stanley-fork/Blackpants/ee/integrated/out/R1.0/fab/asm/2_IMG_20260211_160602.jpg

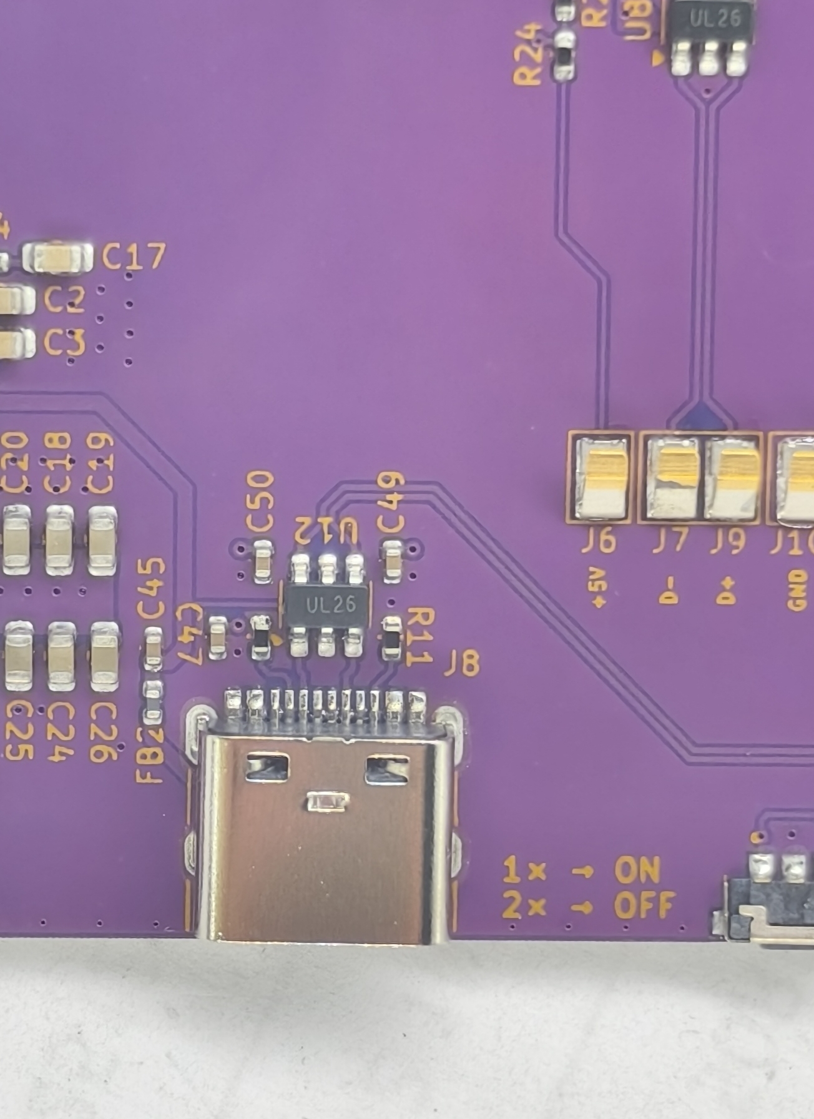
ee/integrated/out/R1.0/fab/asm/2_IMG_20260211_160602.jpg
