stanley-fork/Blackpants/ee/integrated/out/R1.0/fab/asm/3_IMG_20260211_160544.jpg

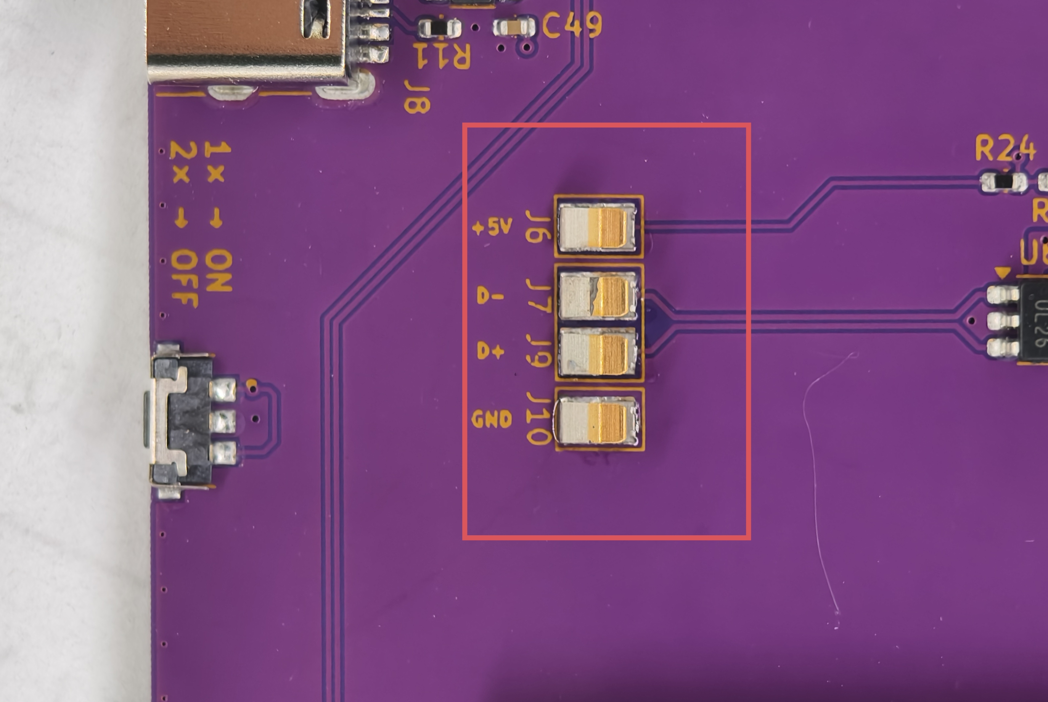
ee/integrated/out/R1.0/fab/asm/3_IMG_20260211_160544.jpg
