stanley-fork/Blackpants/ee/integrated/out/R1.0/readme.txt

Size :	90 x 153 mm
Layer : 4 Layers
Material : FR-4 : S1000H TG150
Thickness : 1.6 mm
Min track/spacing :	4/4mil
Min hole size : 0.2mm
Solder mask : Purple
Silkscreen : Yellow
Edge connector : No
Surface finish : Immersion gold(ENIG) (1U")
Via process : Tenting vias
Finished copper : 1 oz Cu (Inner Copper:1 oz)
Remove product No. : Yes
