stanley-fork/Blackpants/ee/integrated/out/R1.0/fab/asm/1_IMG_20260211_160616.jpg

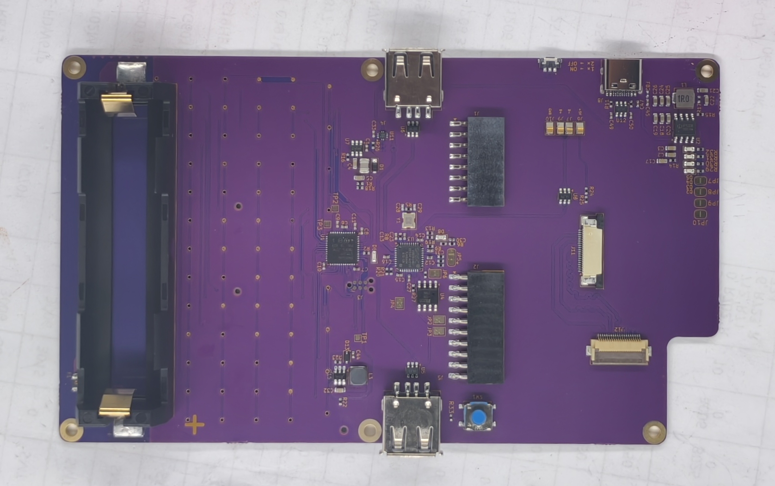
ee/integrated/out/R1.0/fab/asm/1_IMG_20260211_160616.jpg
