stanley-fork/Blackpants/ee/integrated/out/R1.0/fab/asm/4_IMG_20260211_160531.jpg

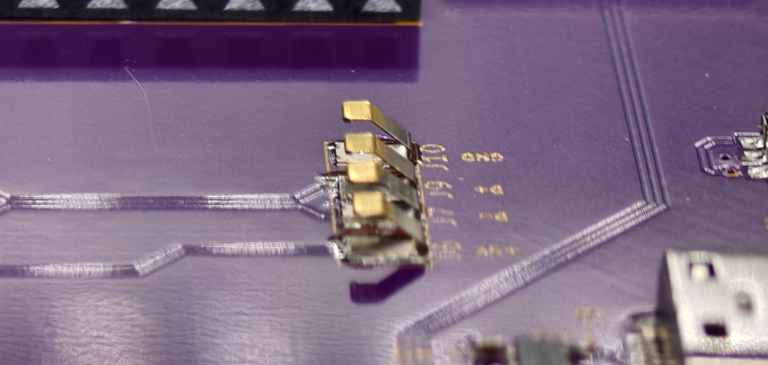
ee/integrated/out/R1.0/fab/asm/4_IMG_20260211_160531.jpg
