stanley-fork/Blackpants/ee/blackpants/step/f32q_20pin_asm.stp

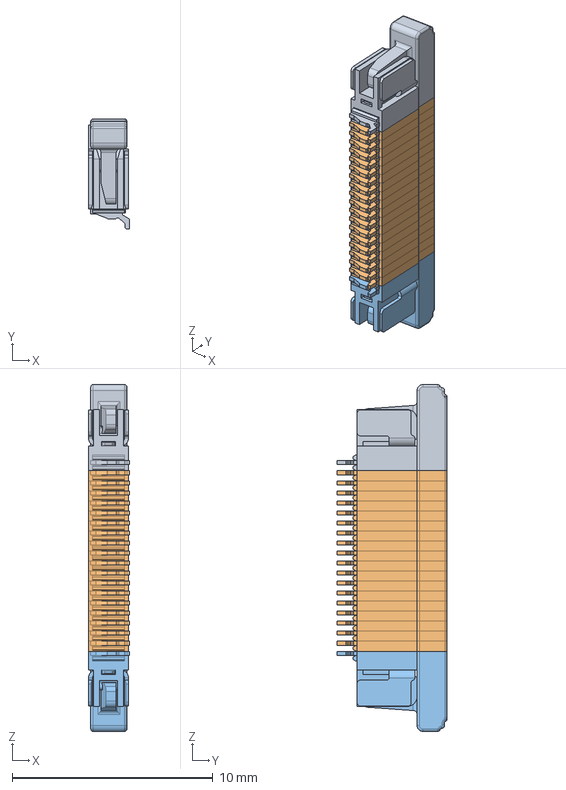
[picture p5: CAD file, 2026-06-06]
ee/blackpants/step/f32q_20pin_asm.stp
2.05 x 5.50 x 17.3 mm
F32Q_L
F32Q_M x 18
F32Q_R
