stanley-fork/Blackpants/ee/blackpants/step/usb1046-xx-0190-l-b-x_revb1.step

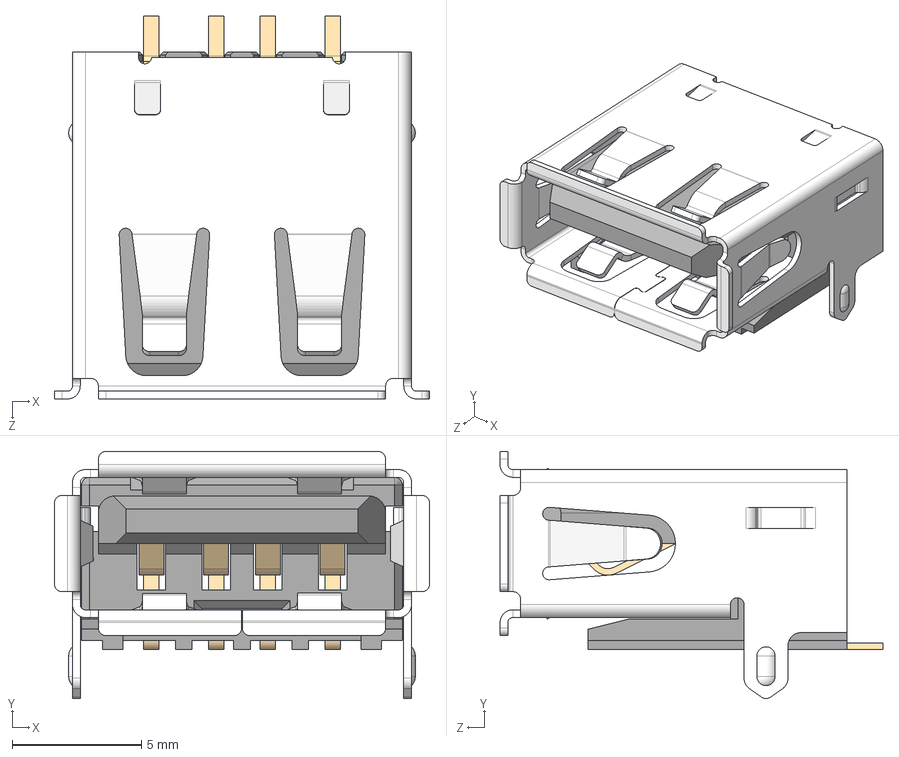
[picture p6: CAD file, 2026-06-06]
ee/blackpants/step/usb1046-xx-0190-l-b-x_revb1.step
14.5 x 9.55 x 14.8 mm
INS
USB1046 shell
USB1046 Contact x 4
