stanley-fork/Blackpants/ee/integrated/Abracon/eec.models/Abracon_-_ABS05-32.768KHZ-9-T.step

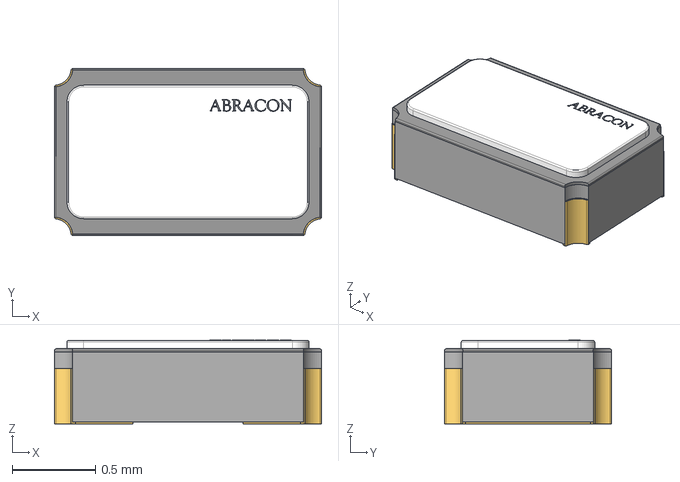
[picture p7: CAD file, 2026-06-06]
ee/integrated/Abracon/eec.models/Abracon_-_ABS05-32.768KHZ-9-T.step
1.60 x 1.00 x 0.501 mm
