stanley-fork/Blackpants/ee/integrated/AS4C512M16D3L/eec.models/Alliance_Memory_-_AS4C512M16D3L-12BIN.step

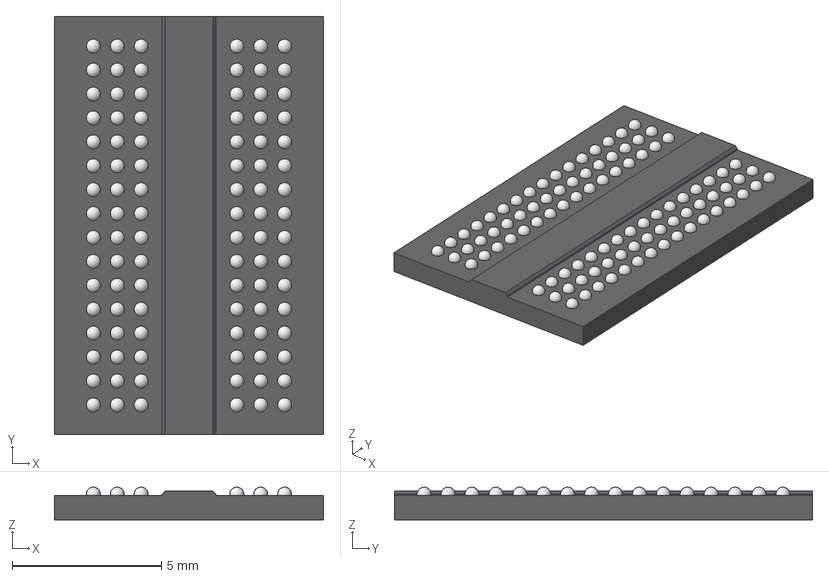
[picture p8: CAD file, 2026-06-06]
ee/integrated/AS4C512M16D3L/eec.models/Alliance_Memory_-_AS4C512M16D3L-12BIN.step
9.00 x 14.0 x 1.09 mm
Part1cvcvcv
Part2sdsdsdsd x 48
Part2sdsdsdsd_MIR x 48
