stanley-fork/Blackpants/ee/integrated/MPM-15-5/eec.models/MEAN_WELL_-_MPM-15-5.step

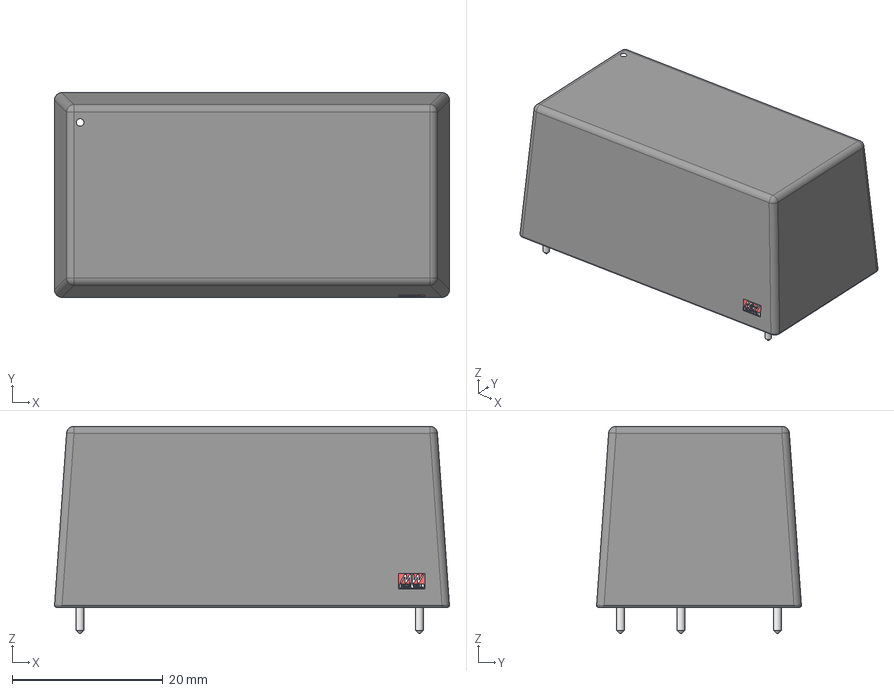
[picture p9: CAD file, 2026-06-06]
ee/integrated/MPM-15-5/eec.models/MEAN_WELL_-_MPM-15-5.step
52.4 x 27.2 x 27.5 mm
Leads
Mean Well logo
Mean Well txt
Frame
Sillkscreen dot
