stanley-fork/Blackpants/ee/integrated/step/Coilcraft-XAL4020.step

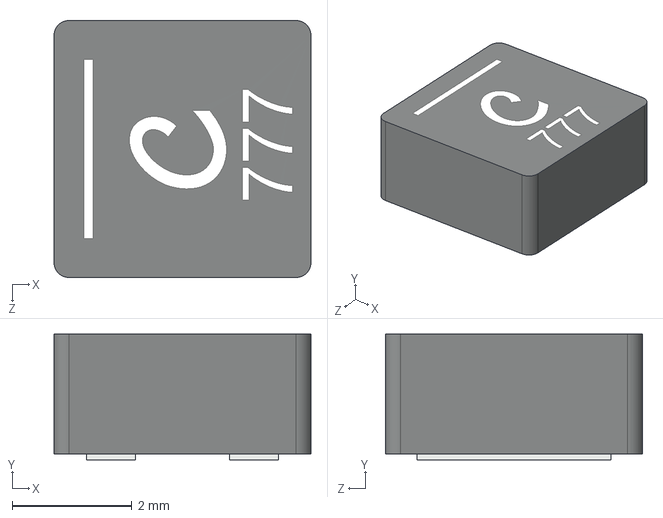
[picture p11: CAD file, 2026-06-06]
ee/integrated/step/Coilcraft-XAL4020.step
4.30 x 2.10 x 4.30 mm
