stanley-fork/Blackpants/ee/integrated/step/CONREVSMA002-G.step

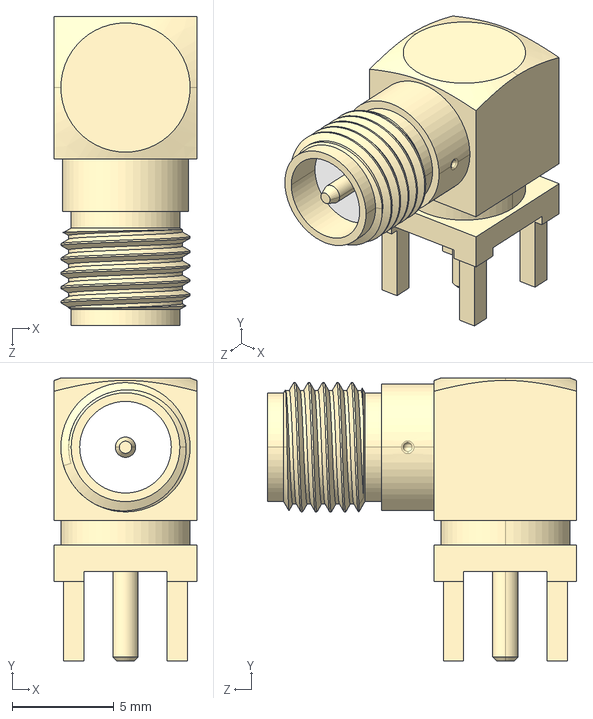
[picture p12: CAD file, 2026-06-06]
ee/integrated/step/CONREVSMA002-G.step
7.00 x 13.9 x 15.2 mm
