stanley-fork/Blackpants/ee/integrated/step/DM3AT-SF-PEJM5.stp

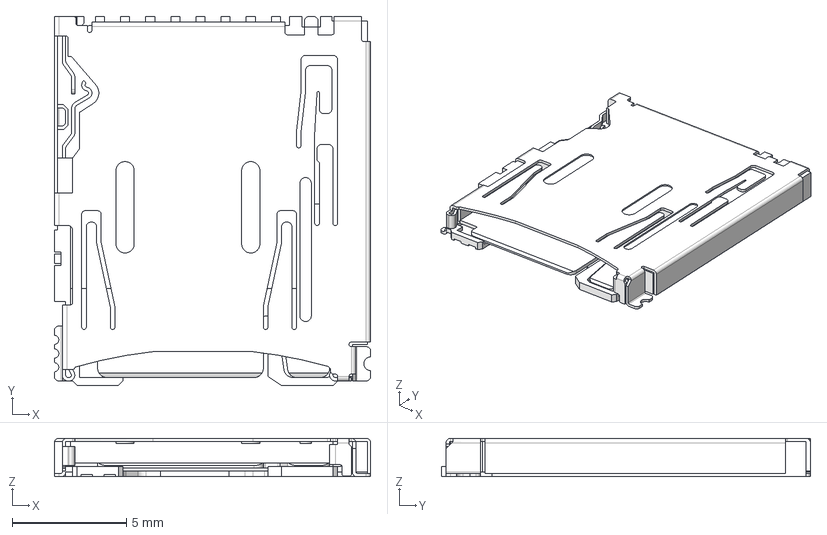
[picture p13: CAD file, 2026-06-06]
ee/integrated/step/DM3AT-SF-PEJM5.stp
13.8 x 16.2 x 1.68 mm
