stanley-fork/Blackpants/ee/integrated/1050570001/1050570001.stp

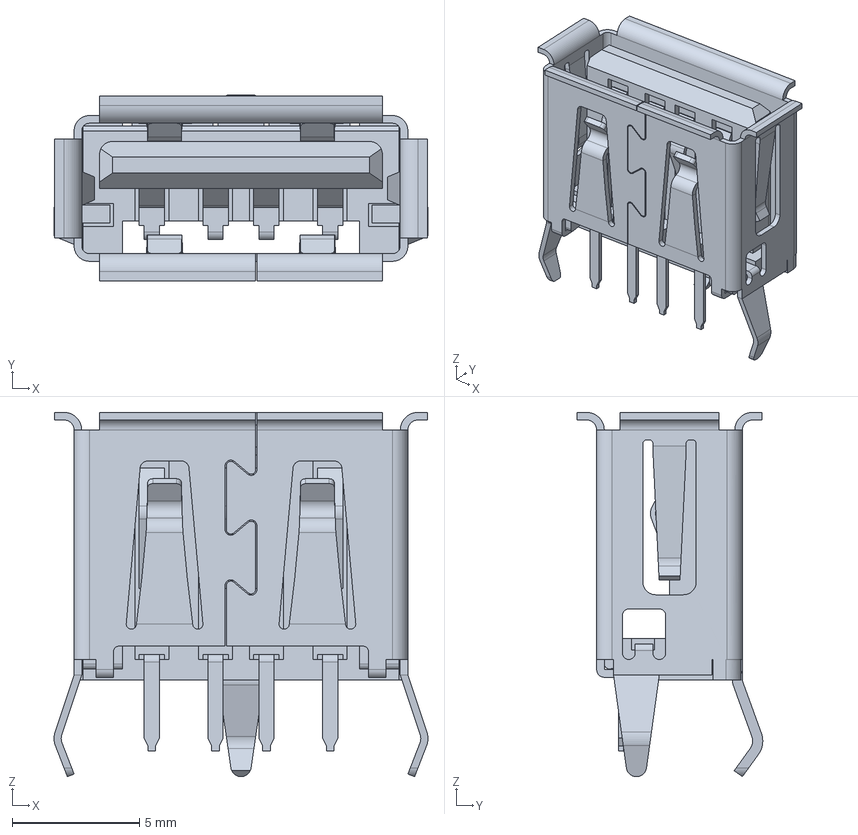
[picture p14: CAD file, 2026-06-06]
ee/integrated/1050570001/1050570001.stp
14.7 x 7.28 x 14.3 mm
