stanley-fork/Blackpants/ee/blackpants/step/M20-7910842R.STEP

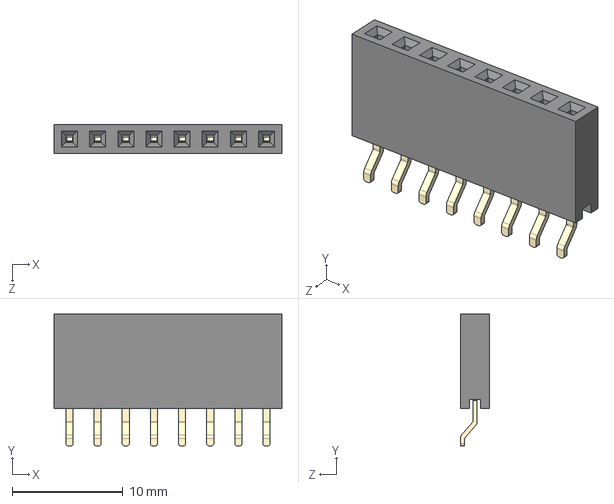
[picture p15: CAD file, 2026-06-06]
ee/blackpants/step/M20-7910842R.STEP
20.6 x 11.9 x 2.65 mm
