stanley-fork/Blackpants/ee/blackpants/step/M20-7911042R.STEP

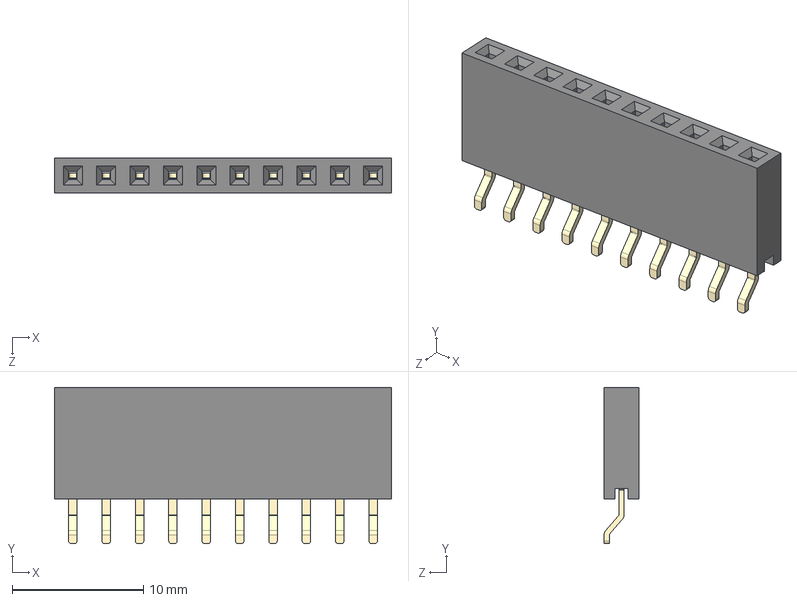
[picture p16: CAD file, 2026-06-06]
ee/blackpants/step/M20-7911042R.STEP
25.6 x 11.9 x 2.65 mm
