stanley-fork/Blackpants/ee/integrated/out/R1.0/blackpants.pdf

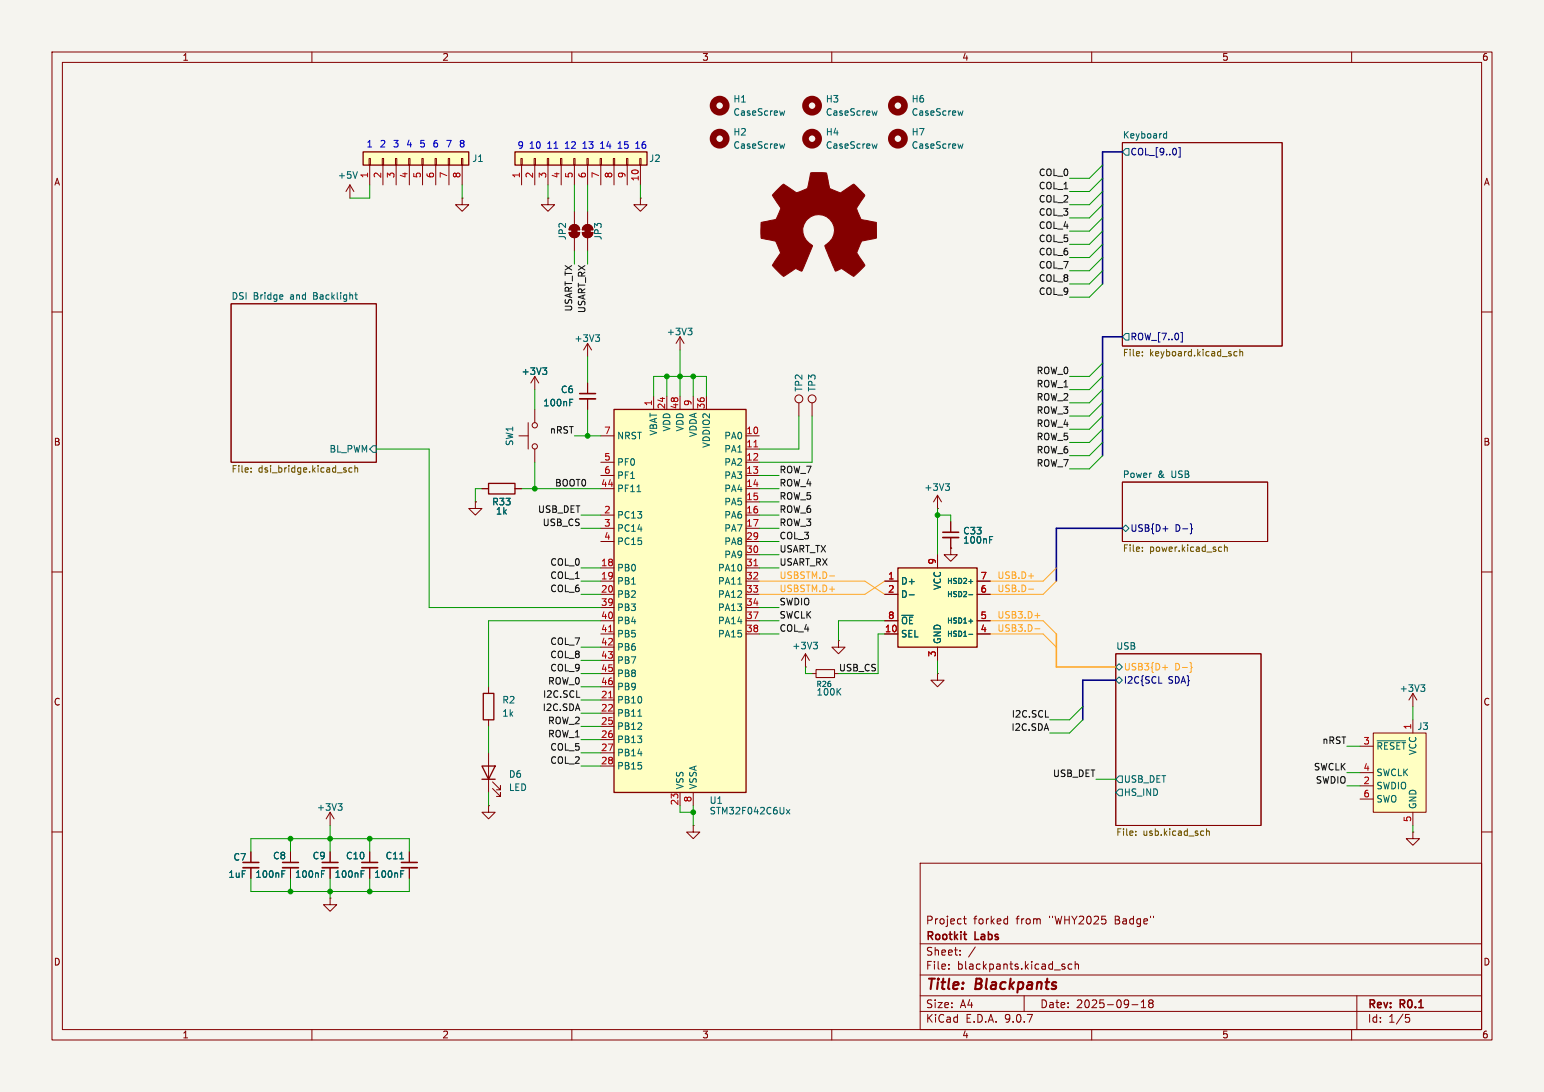
[picture p17: page 1]

DSI Bridge and Backlight File: dsi_bridge.kicad_sch

ROW_[7..0]
File: usb.kicad_sch USB{D+ D-} Power & USB

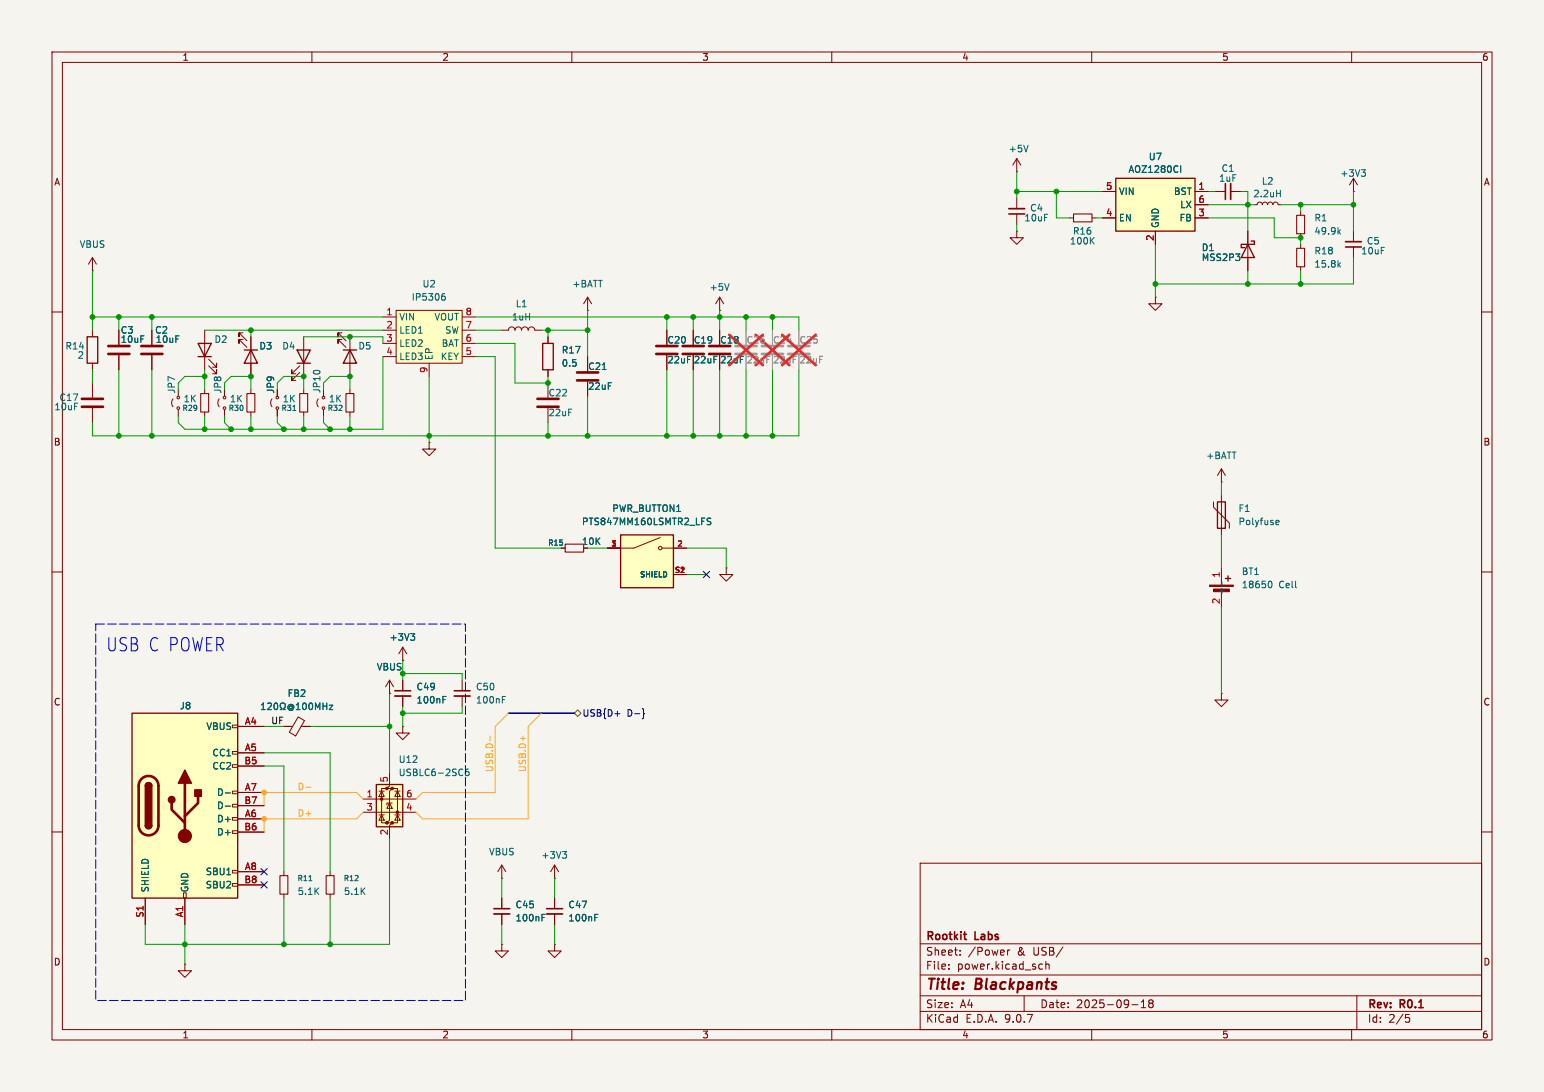
[picture p18: page 2]

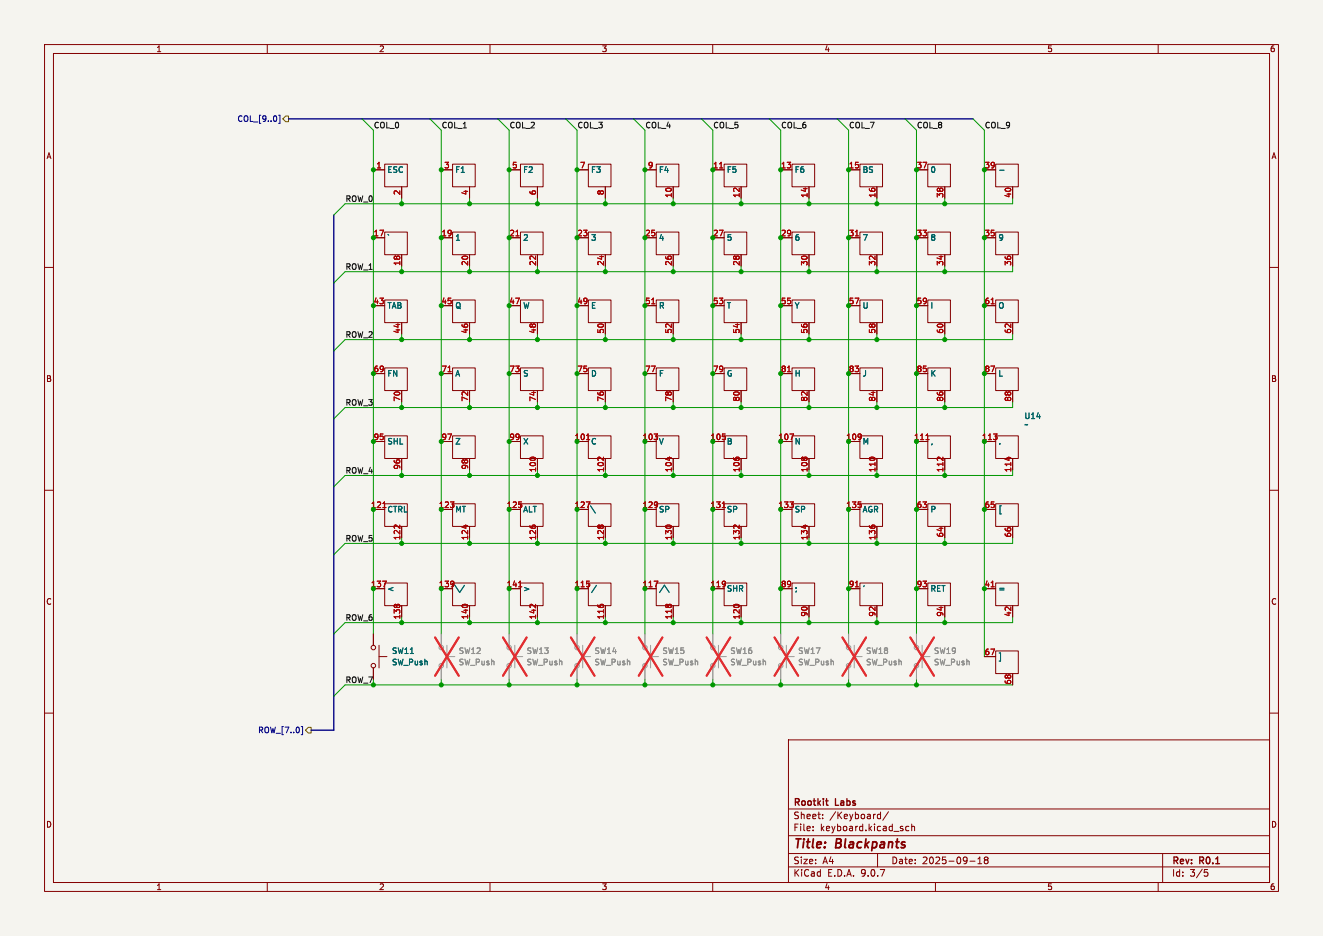
[picture p19: page 3]

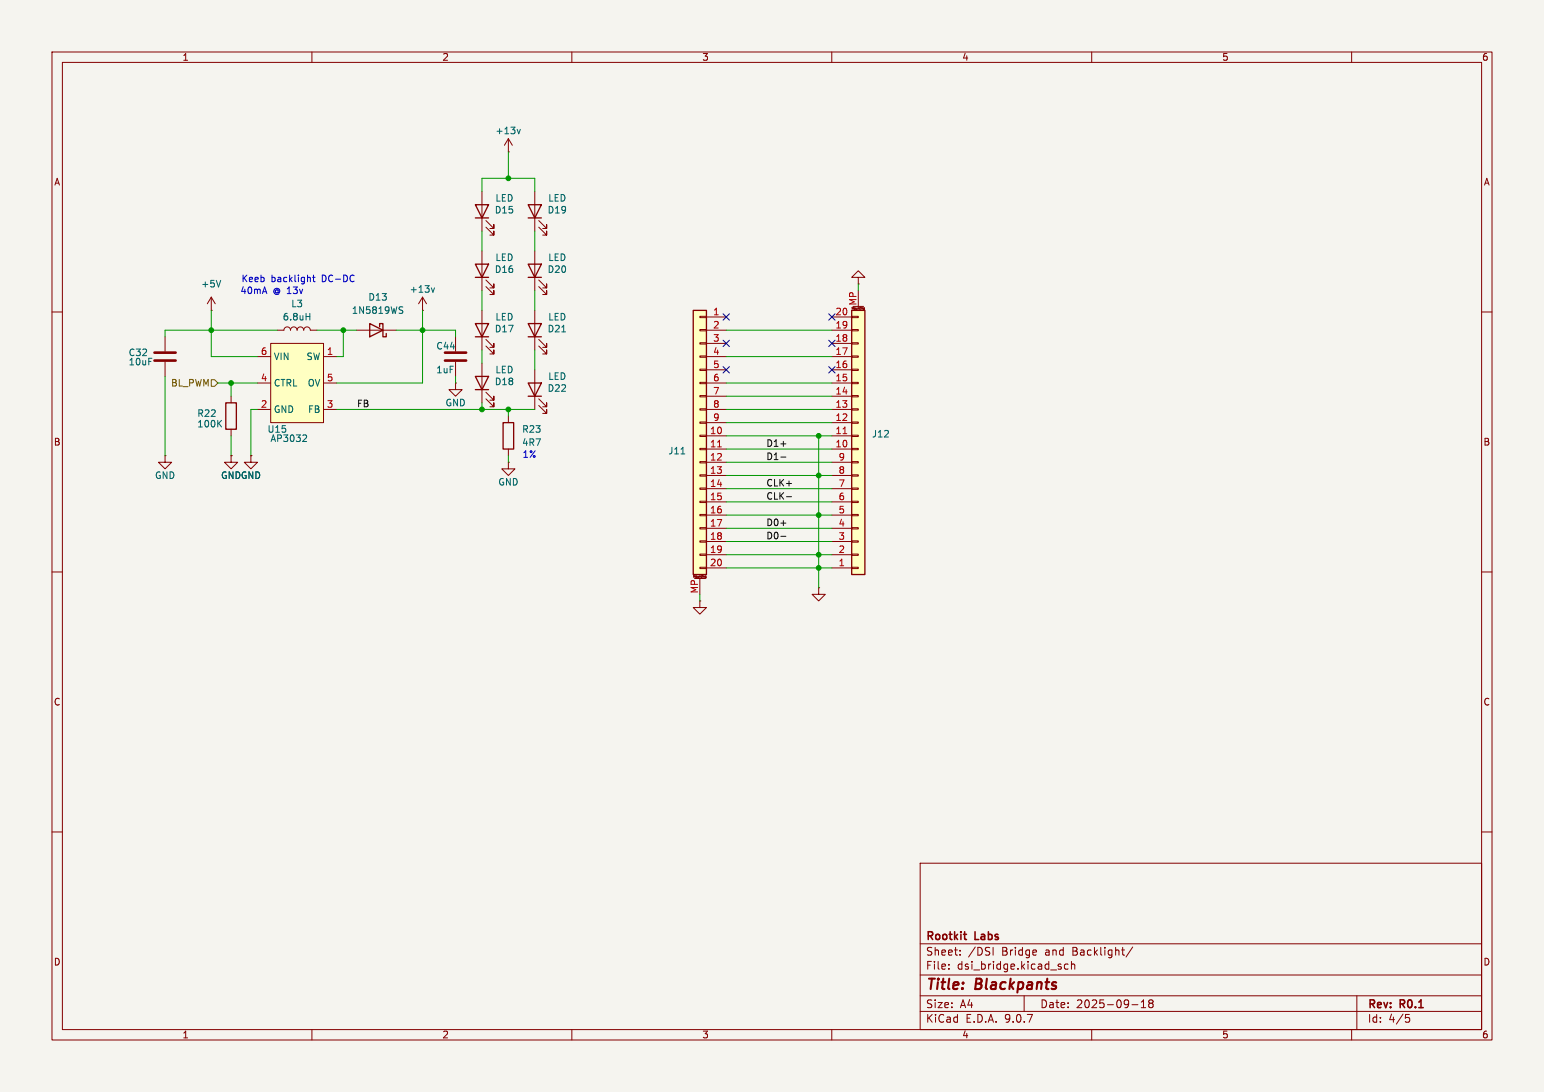
[picture p20: page 4]

11 | 10
12 | 9
13 | 8
14 | 7
15 | 6
16 | 5
17 | 4
18 | 3
19 | 2

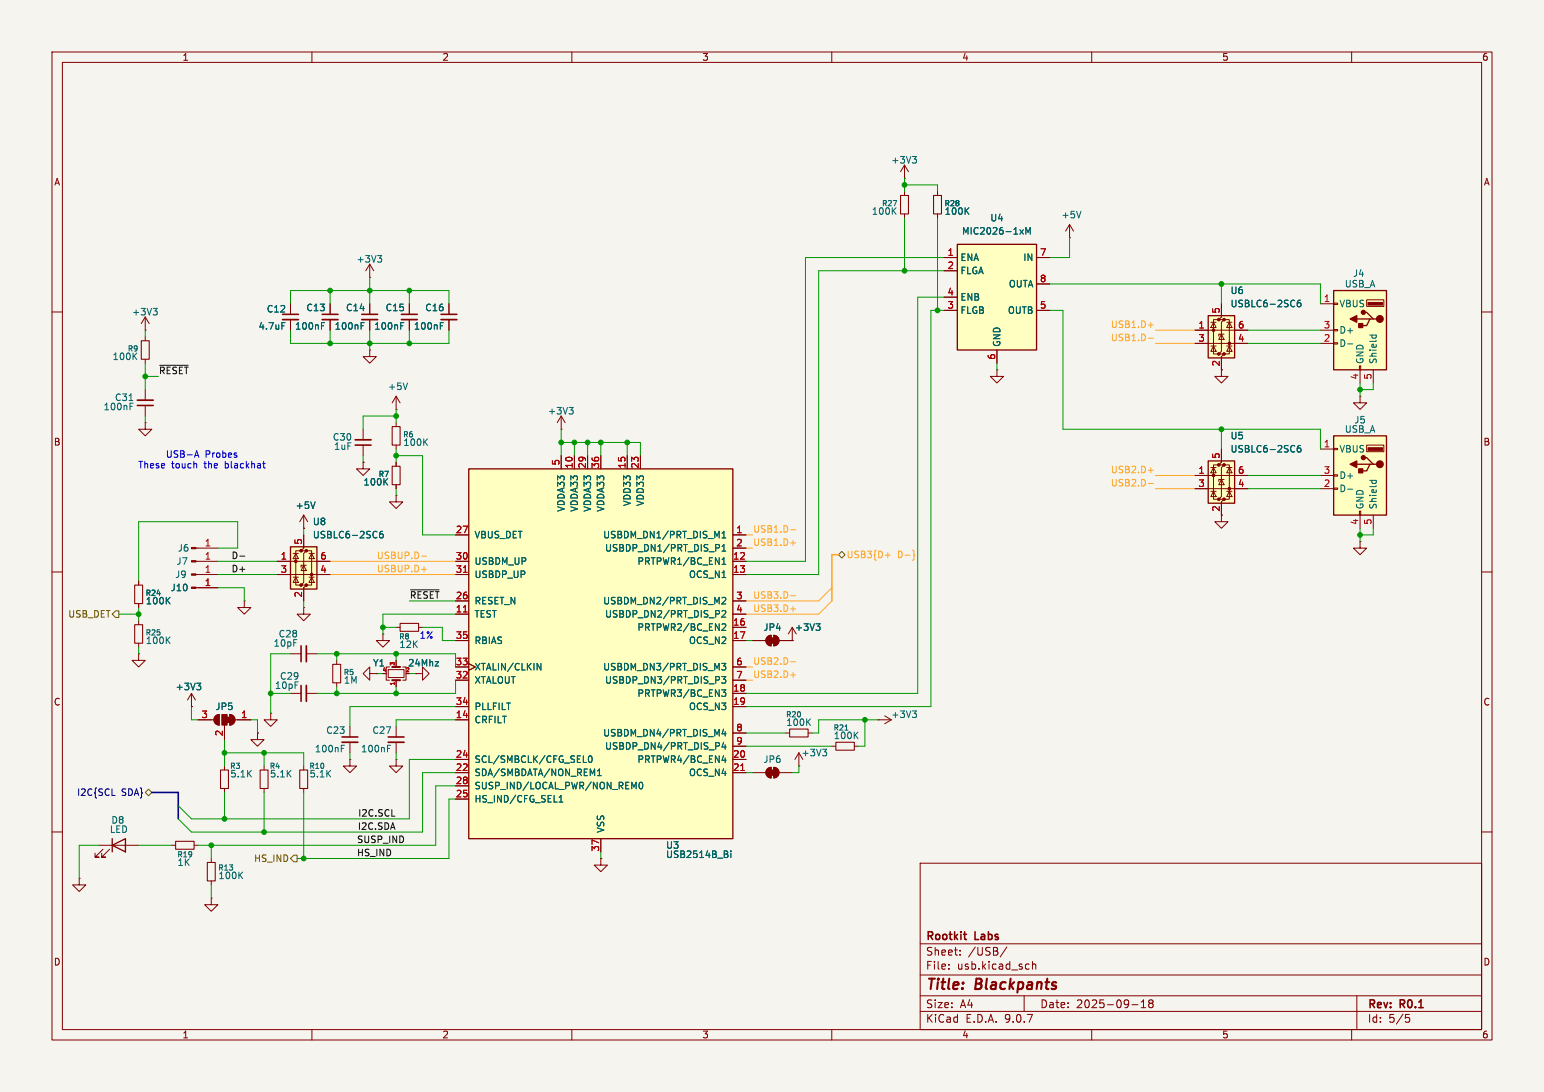
[picture p21: page 5]
