stanley-fork/Blackpants/ee/blackpants/blackpants.kicad_sch

## KiCad design ee/blackpants/blackpants.kicad_sch (2026-06-06)

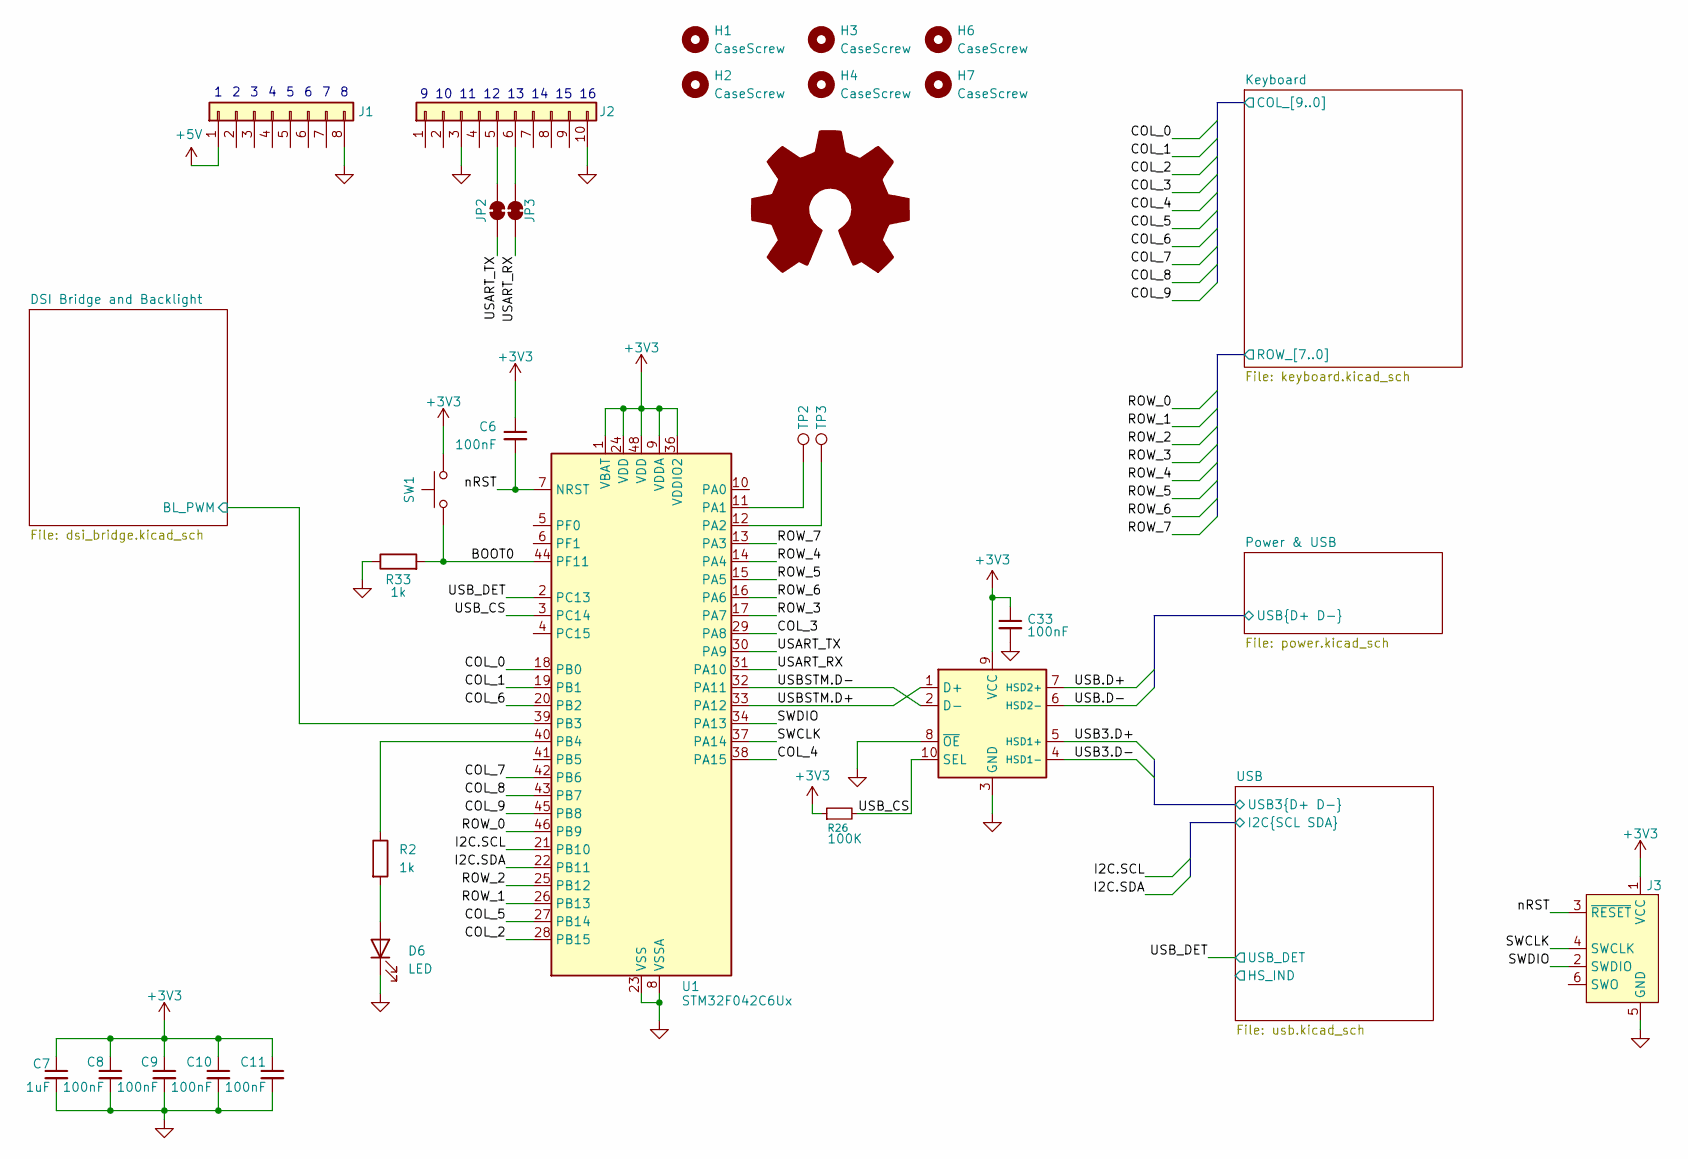
[picture p22: schematic blackpants.kicad_sch]

Parts:
C6, C8, C9, C10, C11, C33: 100nF; C_0402_1005Metric; MPN CL05B104KB54PNC
C7: 1uF; C_0402_1005Metric; MPN CL05B105KQ5NQNC
D6: LED; LED_0603_1608Metric; MPN KT-0603R
H1, H2, H3, H4, H6, H7: CaseScrew; MountingHole_2.7mm_Pad
J1: Conn_01x08; Harwin_M20-89008xx_1x08_P2.54mm_Horizontal; MPN M20-7910842R
J2: Conn_01x10; Harwin_M20-89010xx_1x10_P2.54mm_Horizontal; MPN M20-7911042R
J3: Conn_ARM_SWD_TagConnect_TC2030-NL; Tag-Connect_TC2030-IDC-NL_2x03_P1.27mm_Vertical
JP2, JP3: SolderJumper_2_Bridged; SolderJumper-2_P1.3mm_Bridged_Pad1.0x1.5mm
R2, R33: 1k; R_0402_1005Metric; MPN 0402WGF1001TCE
R26: 100K; R_0402_1005Metric; MPN RC0402FR-13100KL
S1: Logo_Open_Hardware_Large; OSHW-Logo2_24.3x20mm_SilkScreen
SW1: SW_Push; SW_Push_1P1T_NO_CK_KSC7xxJ; MPN KSC741JLFS
TP2, TP3: TestPoint; TestPoint_Pad_1.0x1.0mm
U1: STM32F042C6Ux; QFN-48-1EP_7x7mm_P0.5mm_EP5.6x5.6mm; MPN STM32F042C6U6
U11: TPSGM7227YUWQ10G; UQFN-10_1.4x1.8mm_P0.4mm; MPN TPSGM7227YUWQ10G

Connections:
+3V3: C6.1, C7.1, C8.1, C9.1, C10.1, C11.1, C33.1, J3.1 (VCC), R26.1, SW1.2, U1.1 (VBAT), U1.9 (VDDA), U1.24 (VDD), U1.36 (VDDIO2), U1.48 (VDD), U11.9 (VCC)
+5V: J1.1
BL_PWM: U1.39 (PB3)
BOOT0: R33.2, SW1.1, U1.44 (PF11)
COL_0: U1.18 (PB0)
COL_1: U1.19 (PB1)
COL_2: U1.28 (PB15)
COL_3: U1.29 (PA8)
COL_4: U1.38 (PA15)
COL_5: U1.27 (PB14)
COL_6: U1.20 (PB2)
COL_7: U1.42 (PB6)
COL_8: U1.43 (PB7)
COL_9: U1.45 (PB8)
GND: C7.2, C8.2, C9.2, C10.2, C11.2, C33.2, D6.1 (K), J1.8, J2.3, J2.10, J3.5 (GND), R33.1, U1.8 (VSSA), U1.23 (VSS), U1.35 (VSS), U1.47 (VSS), U1.49 (VSS), U11.3 (GND), U11.8 (~OE)
I2C.SCL: U1.21 (PB10)
I2C.SDA: U1.22 (PB11)
unnamed: D6.2 (A), R2.2
unnamed: J2.5, JP2.1 (A)
unnamed: J2.6, JP3.1 (A)
unnamed: R2.1, U1.40 (PB4)
unnamed: TP2.1, U1.11 (PA1)
unnamed: TP3.1, U1.12 (PA2)
ROW_0: U1.46 (PB9)
ROW_1: U1.26 (PB13)
ROW_2: U1.25 (PB12)
ROW_3: U1.17 (PA7)
ROW_4: U1.14 (PA4)
ROW_5: U1.15 (PA5)
ROW_6: U1.16 (PA6)
ROW_7: U1.13 (PA3)
SWCLK: J3.4 (SWCLK), U1.37 (PA14)
SWDIO: J3.2 (SWDIO), U1.34 (PA13)
USART_RX: JP3.2 (B), U1.31 (PA10)
USART_TX: JP2.2 (B), U1.30 (PA9)
USB3.D+: U11.5 (HSD1+)
USB3.D-: U11.4 (HSD1-)
USB.D+: U11.7 (HSD2+)
USB.D-: U11.6 (HSD2-)
USBSTM.D+: U1.33 (PA12), U11.1 (D+)
USBSTM.D-: U1.32 (PA11), U11.2 (D-)
USB_CS: R26.2, U1.3 (PC14), U11.10 (SEL)
USB_DET: U1.2 (PC13)
nRST: C6.2, J3.3 (~RESET), U1.7 (NRST)

Notes on the sheet:
9 10 11 12 13 14 15 16
