stanley-fork/Blackpants/ee/blackpants/dsi_bridge.kicad_sch

## KiCad design ee/blackpants/dsi_bridge.kicad_sch (2026-06-06)

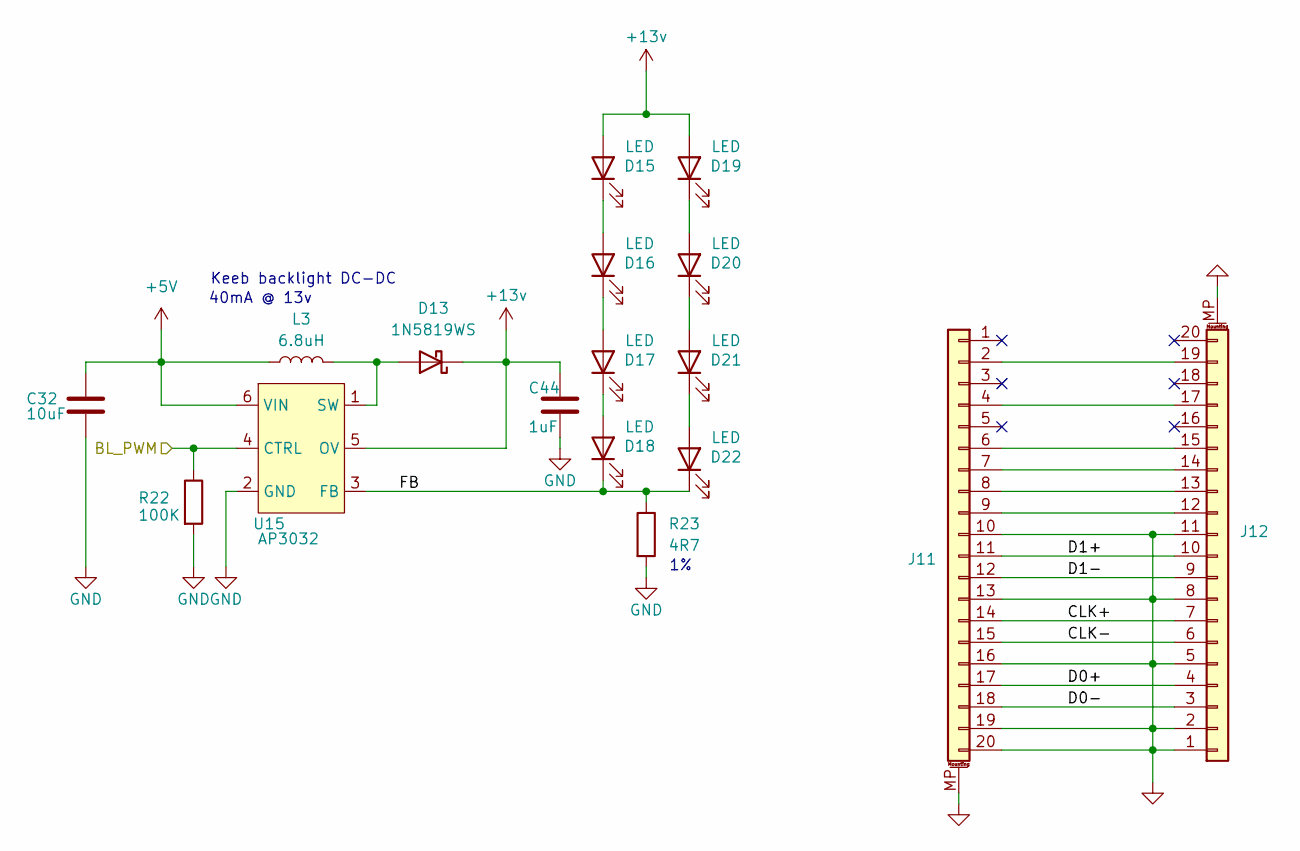
[picture p23: schematic dsi_bridge.kicad_sch]

Parts:
C32: 10uF; C_0603_1608Metric; MPN CL10A106MA8NRNC
C44: 1uF; C_0402_1005Metric; MPN CL05B105KQ5NQNC
D13: 1N5819WS; D_SOD-323; MPN 1N5819WS
D15, D16, D17, D18, D19, D20, D21, D22: LED; LTW-010DCG; MPN LTW-010DCG
J11: Conn_01x20_MountingPin; Amphenol_F32Q-1A7x1-11020_1x20-1MP_P0.5mm_Horizontal; MPN F32Q-1A7H1-11020
J12: Conn_01x20_MountingPin; Hirose_FH12-20S-0.5SH_1x20-1MP_P0.50mm_Horizontal; MPN FH12-20S-0.5SH(55)
L3: 6.8uH; L_Vishay_IFSC-1515AH_4x4x1.8mm; MPN IFSC1515AHER6R8M01
R22: 100K; R_0402_1005Metric; MPN RC0402FR-13100KL
R23: 4R7; R_0402_1005Metric; MPN 0402WGF470KTCE
U15: AP3032; SOT-23-6_Handsoldering; MPN AP3032KTR-G1

Connections:
+5V: C32.1, L3.1, U15.6 (VIN)
+13v: C44.1, D13.1 (K), D15.2 (A), D19.2 (A), U15.5 (OV)
BL_PWM: R22.1, U15.4 (CTRL)
CLK+: J11.14, J12.7
CLK-: J11.15, J12.6
D0+: J11.17, J12.4
D0-: J11.18, J12.3
D1+: J11.11, J12.10
D1-: J11.12, J12.9
FB: D18.1 (K), D22.1 (K), R23.1, U15.3 (FB)
GND: C32.2, C44.2, J11.10, J11.13, J11.16, J11.19, J11.20, J11.MP (MountPin), J12.1, J12.2, J12.5, J12.8, J12.11, J12.MP (MountPin), R22.2, R23.2, U15.2 (GND)
unnamed: D13.2 (A), L3.2, U15.1 (SW)
unnamed: D15.1 (K), D16.2 (A)
unnamed: D16.1 (K), D17.2 (A)
unnamed: D17.1 (K), D18.2 (A)
unnamed: D19.1 (K), D20.2 (A)
unnamed: D20.1 (K), D21.2 (A)
unnamed: D21.1 (K), D22.2 (A)
unnamed: J11.2, J12.19
unnamed: J11.4, J12.17
unnamed: J11.6, J12.15
unnamed: J11.7, J12.14
unnamed: J11.8, J12.13
unnamed: J11.9, J12.12

Notes on the sheet:
40mA @ 13v
Keeb backlight DC-DC
