stanley-fork/Blackpants/ee/blackpants/keyboard.kicad_sch

## KiCad design ee/blackpants/keyboard.kicad_sch (2026-06-06)

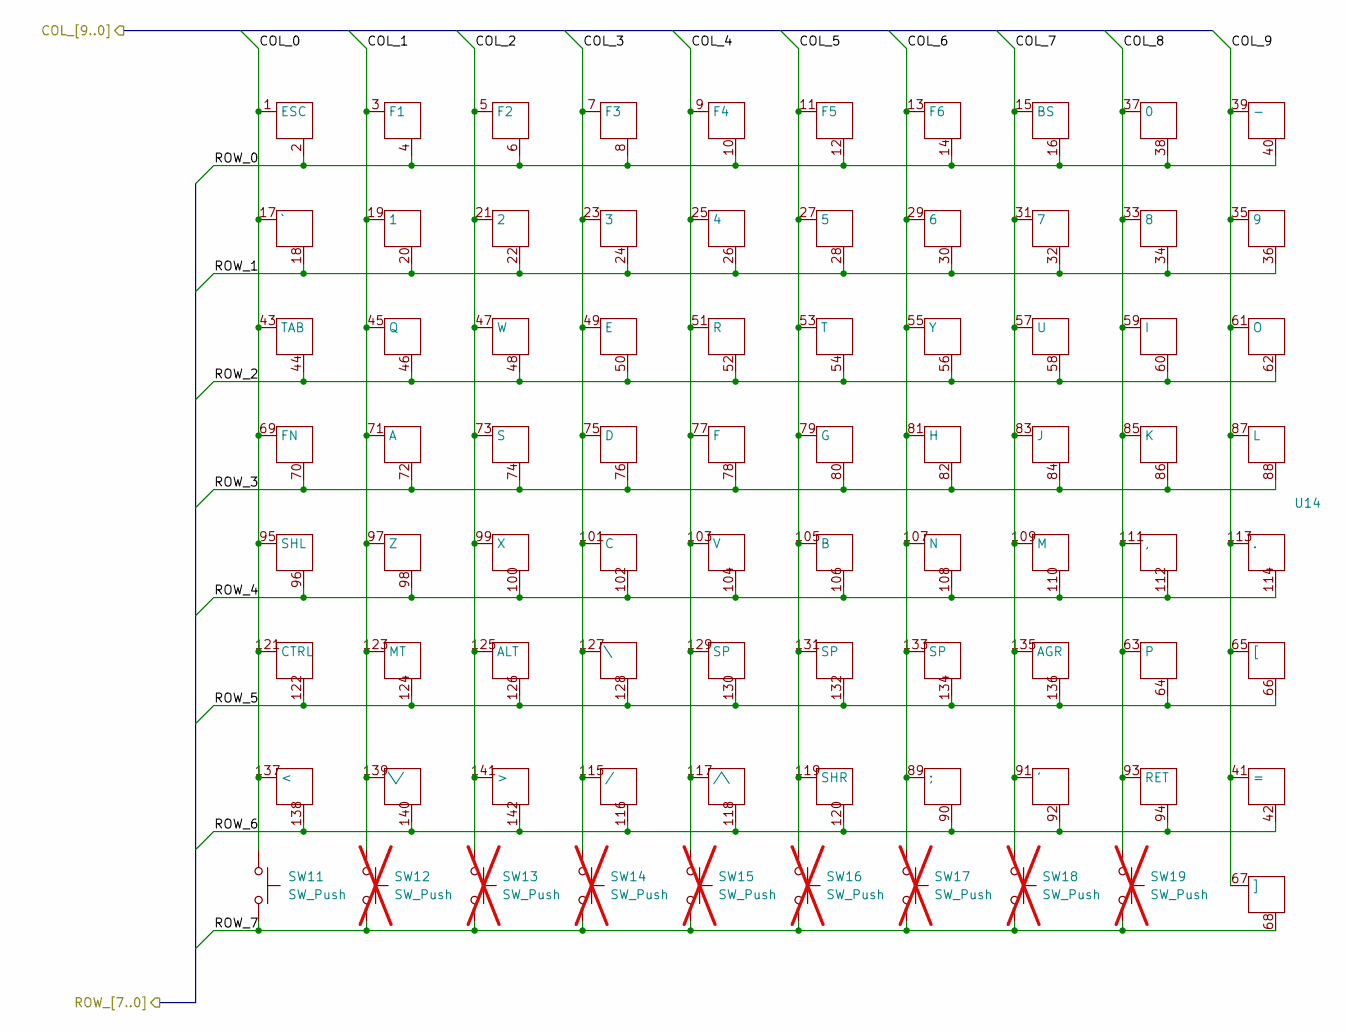
[picture p24: schematic keyboard.kicad_sch]

Parts:
SW11: SW_Push; SW_Push_1P1T_NO_CK_KSC7xxJ
SW12, SW13, SW14, SW15, SW16, SW17, SW18, SW19: SW_Push; SW_Push_1P1T_NO_CK_KSC7xxJ; not fitted
U14: keyboard_arturo182

Connections:
COL_0: SW11.1, U14.1 (ESC), U14.17 (`), U14.43 (TAB), U14.69 (FN), U14.95 (SHL), U14.121 (CTRL), U14.137 (<)
COL_1: SW12.1, U14.3 (F1), U14.19 (1), U14.45 (Q), U14.71 (A), U14.97 (Z), U14.123 (MT), U14.139 (\/)
COL_2: SW13.1, U14.5 (F2), U14.21 (2), U14.47 (W), U14.73 (S), U14.99 (X), U14.125 (ALT), U14.141 (>)
COL_3: SW14.1, U14.7 (F3), U14.23 (3), U14.49 (E), U14.75 (D), U14.101 (C), U14.115 (/), U14.127 (\)
COL_4: SW15.1, U14.9 (F4), U14.25 (4), U14.51 (R), U14.77 (F), U14.103 (V), U14.117 (/\), U14.129 (SP)
COL_5: SW16.1, U14.11 (F5), U14.27 (5), U14.53 (T), U14.79 (G), U14.105 (B), U14.119 (SHR), U14.131 (SP)
COL_6: SW17.1, U14.13 (F6), U14.29 (6), U14.55 (Y), U14.81 (H), U14.89 (;), U14.107 (N), U14.133 (SP)
COL_7: SW18.1, U14.15 (BS), U14.31 (7), U14.57 (U), U14.83 (J), U14.91 ('), U14.109 (M), U14.135 (AGR)
COL_8: SW19.1, U14.33 (8), U14.37 (0), U14.59 (I), U14.63, U14.85 (K), U14.93 (RET), U14.111 (,)
COL_9: U14.35 (9), U14.39 (-), U14.41 (=), U14.61 (O), U14.65 ([), U14.67 (]), U14.87 (L), U14.113 (.)
ROW_0: U14.2, U14.4, U14.6, U14.8, U14.10, U14.12, U14.14, U14.16, U14.38, U14.40
ROW_1: U14.18, U14.20, U14.22, U14.24, U14.26, U14.28, U14.30, U14.32, U14.34, U14.36
ROW_2: U14.44, U14.46, U14.48, U14.50, U14.52, U14.54, U14.56, U14.58, U14.60, U14.62
ROW_3: U14.70, U14.72, U14.74, U14.76, U14.78, U14.80, U14.82, U14.84, U14.86, U14.88
ROW_4: U14.96, U14.98, U14.100, U14.102, U14.104, U14.106, U14.108, U14.110, U14.112, U14.114
ROW_5: U14.64, U14.66, U14.122, U14.124, U14.126, U14.128, U14.130, U14.132, U14.134, U14.136
ROW_6: U14.42, U14.90, U14.92, U14.94, U14.116, U14.118, U14.120, U14.138, U14.140, U14.142
ROW_7: SW11.2, SW12.2, SW13.2, SW14.2, SW15.2, SW16.2, SW17.2, SW18.2, SW19.2, U14.68
