stanley-fork/Blackpants/ee/blackpants/power.kicad_sch

## KiCad design ee/blackpants/power.kicad_sch (2026-06-06)

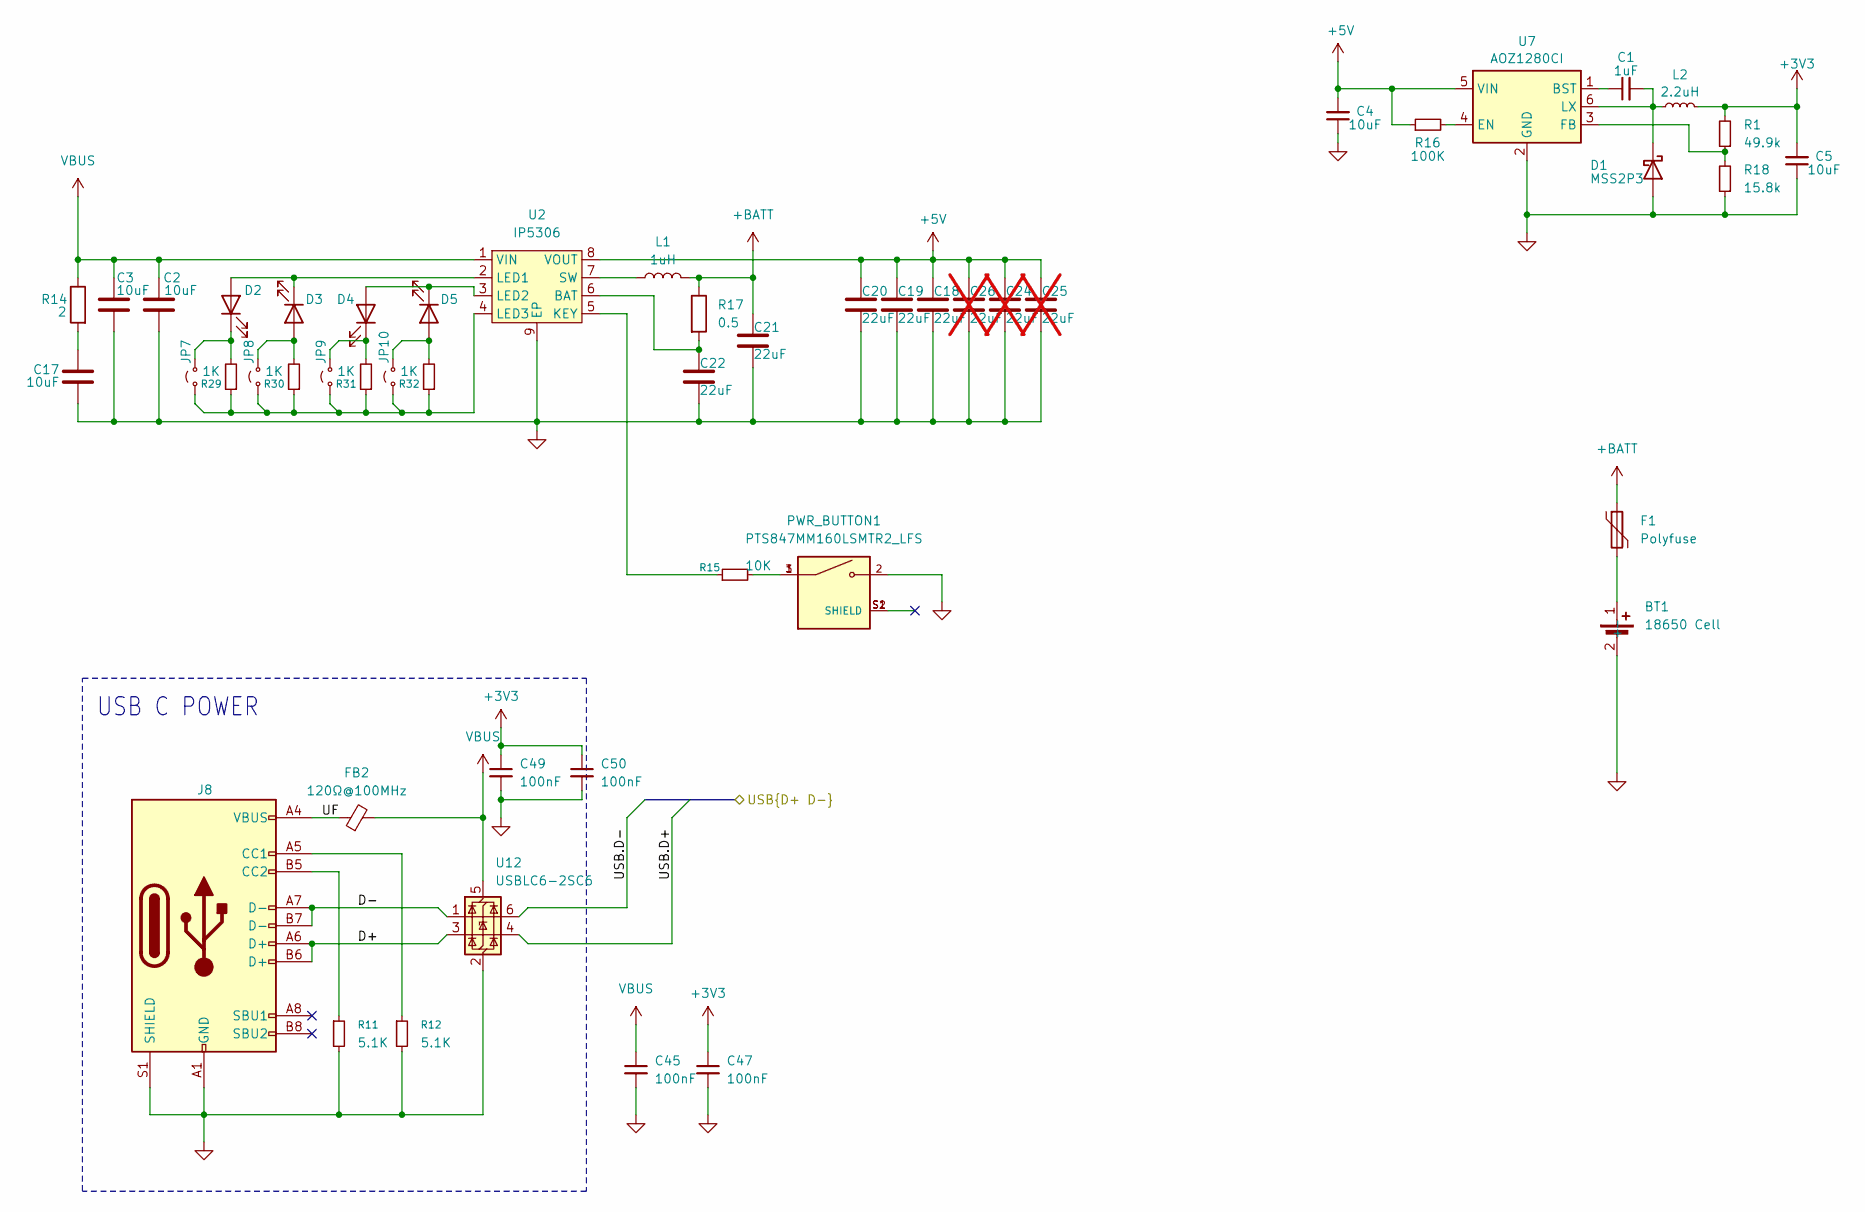
[picture p25: schematic power.kicad_sch]

Parts:
BT1: 18650 Cell; BH-18650-B1BA002; MPN BH-18650-B1BA002
C1: 1uF; C_0402_1005Metric; MPN CL05B105KQ5NQNC
C2, C3, C4, C5, C17: 10uF; C_0603_1608Metric; MPN CL10A106MA8NRNC
C18, C19, C20, C21, C22: 22uF; C_0603_1608Metric; MPN CL10A226MQ8NRNC
C24, C25, C26: 22uF; C_0603_1608Metric; MPN CL10A226MQ8NRNC; not fitted
C45, C47, C49, C50: 100nF; C_0402_1005Metric; MPN CL05B104KB54PNC
D1: MSS2P3; D_MicroSMP_AK; MPN MSS2P3-M3/89A
D2, D3, D4, D5: LED; LED_0603_1608Metric; MPN KT-0603R
F1: Polyfuse; Fuse_1206_3216Metric; MPN SMD1206P200TF
FB2: 120Ω@100MHz; L_0402_1005Metric; MPN BLM15PD121SN1D
J8: USB_C_Receptacle_USB2.0_16P; USB_C_Receptacle_HRO_TYPE-C-31-M-12; MPN TYPE-C-31-M-12
JP7, JP8, JP9, JP10: Jumper_2_Small_Open; SolderJumper-2_P1.3mm_Open_RoundedPad1.0x1.5mm
L1: 1uH; L_Changjiang_FXL0420; MPN RS0420-1R0MS
L2: 2.2uH; L_1008_2520Metric; MPN DFE252012P-2R2M=P2
PWR_BUTTON1: PTS847MM160LSMTR2_LFS; SW_PTS847MM160SMTR2_LFS; MPN PTS847MM160SMTR2LFS
R1: 49.9k; R_0402_1005Metric; MPN RC0402FR-1349K9L
R11, R12: 5.1K; R_0402_1005Metric; MPN RC0402FR-135K1L
R14: 2; R_0402_1005Metric; MPN 0402WGJ020JTCE
R15: 10K; R_0402_1005Metric; MPN 0402WGF1002TCE
R16: 100K; R_0402_1005Metric; MPN RC0402FR-13100KL
R17: 0.5; R_0402_1005Metric; MPN RTT02R500FTH
R18: 15.8k; R_0402_1005Metric; MPN RC0402FR-1315K8L
R29, R30, R31, R32: 1K; R_0402_1005Metric; MPN 0402WGF1001TCE
U2: IP5306; HSOP-8-1EP_3.9x4.9mm_P1.27mm_EP2.41x3.1mm_ThermalVias; MPN IP5306; LCSC C181692
U7: AOZ1280CI; SOT-23-6; MPN AOZ1280CI
U12: USBLC6-2SC6; SOT-23-6; MPN USBLC6-2SC6

Connections:
+3V3: C5.2, C47.1, C49.1, C50.1, L2.2, R1.2
+5V: C4.2, C18.1, C19.1, C20.1, C24.1, C25.1, C26.1, R16.1, U2.8 (VOUT), U7.5 (VIN)
+BATT: C21.1, F1.1, L1.2, R17.1
D+: J8.A6 (D+), J8.B6 (D+), U12.3 (I/O2)
D-: J8.A7 (D-), J8.B7 (D-), U12.1 (I/O1)
GND: BT1.2 (-), C2.2, C3.2, C4.1, C5.1, C17.2, C18.2, C19.2, C20.2, C21.2, C22.2, C24.2, C25.2, C26.2, C45.2, C47.2, C49.2, C50.2, D1.2 (A), J8.A1 (GND), J8.A12 (GND), J8.B1 (GND), J8.B12 (GND), J8.S1 (SHIELD), PWR_BUTTON1.2, R11.2, R12.2, R18.1, U2.9 (EP), U7.2 (GND), U12.2 (GND)
unnamed: BT1.1 (+), F1.2
unnamed: C1.1, U7.1 (BST)
unnamed: C1.2, D1.1 (K), L2.1, U7.6 (LX)
unnamed: C17.1, R14.2
unnamed: C22.1, R17.2, U2.6 (BAT)
unnamed: D2.1 (K), JP7.2 (B), R29.2
unnamed: D2.2 (A), D3.1 (K), U2.2 (LED1)
unnamed: D3.2 (A), JP8.2 (B), R30.2
unnamed: D4.1 (K), JP9.2 (B), R31.2
unnamed: D4.2 (A), D5.1 (K), U2.3 (LED2)
unnamed: D5.2 (A), JP10.2 (B), R32.2
unnamed: J8.A5 (CC1), R12.1
unnamed: J8.B5 (CC2), R11.1
unnamed: JP7.1 (A), JP8.1 (A), JP9.1 (A), JP10.1 (A), R29.1, R30.1, R31.1, R32.1, U2.4 (LED3)
unnamed: L1.1, U2.7 (SW)
unnamed: PWR_BUTTON1.1, PWR_BUTTON1.3, R15.2
unnamed: PWR_BUTTON1.S1 (SHIELD), PWR_BUTTON1.S2 (SHIELD)
unnamed: R1.1, R18.2, U7.3 (FB)
unnamed: R15.1, U2.5 (KEY)
unnamed: R16.2, U7.4 (EN)
UF: FB2.1, J8.A4 (VBUS), J8.A9 (VBUS), J8.B4 (VBUS), J8.B9 (VBUS)
USB.D+: U12.4 (I/O2)
USB.D-: U12.6 (I/O1)
VBUS: C2.1, C3.1, C45.1, FB2.2, R14.1, U2.1 (VIN), U12.5 (VBUS)

Notes on the sheet:
USB C POWER
