stanley-fork/Blackpants/ee/blackpants/usb.kicad_sch

## KiCad design ee/blackpants/usb.kicad_sch (2026-06-06)

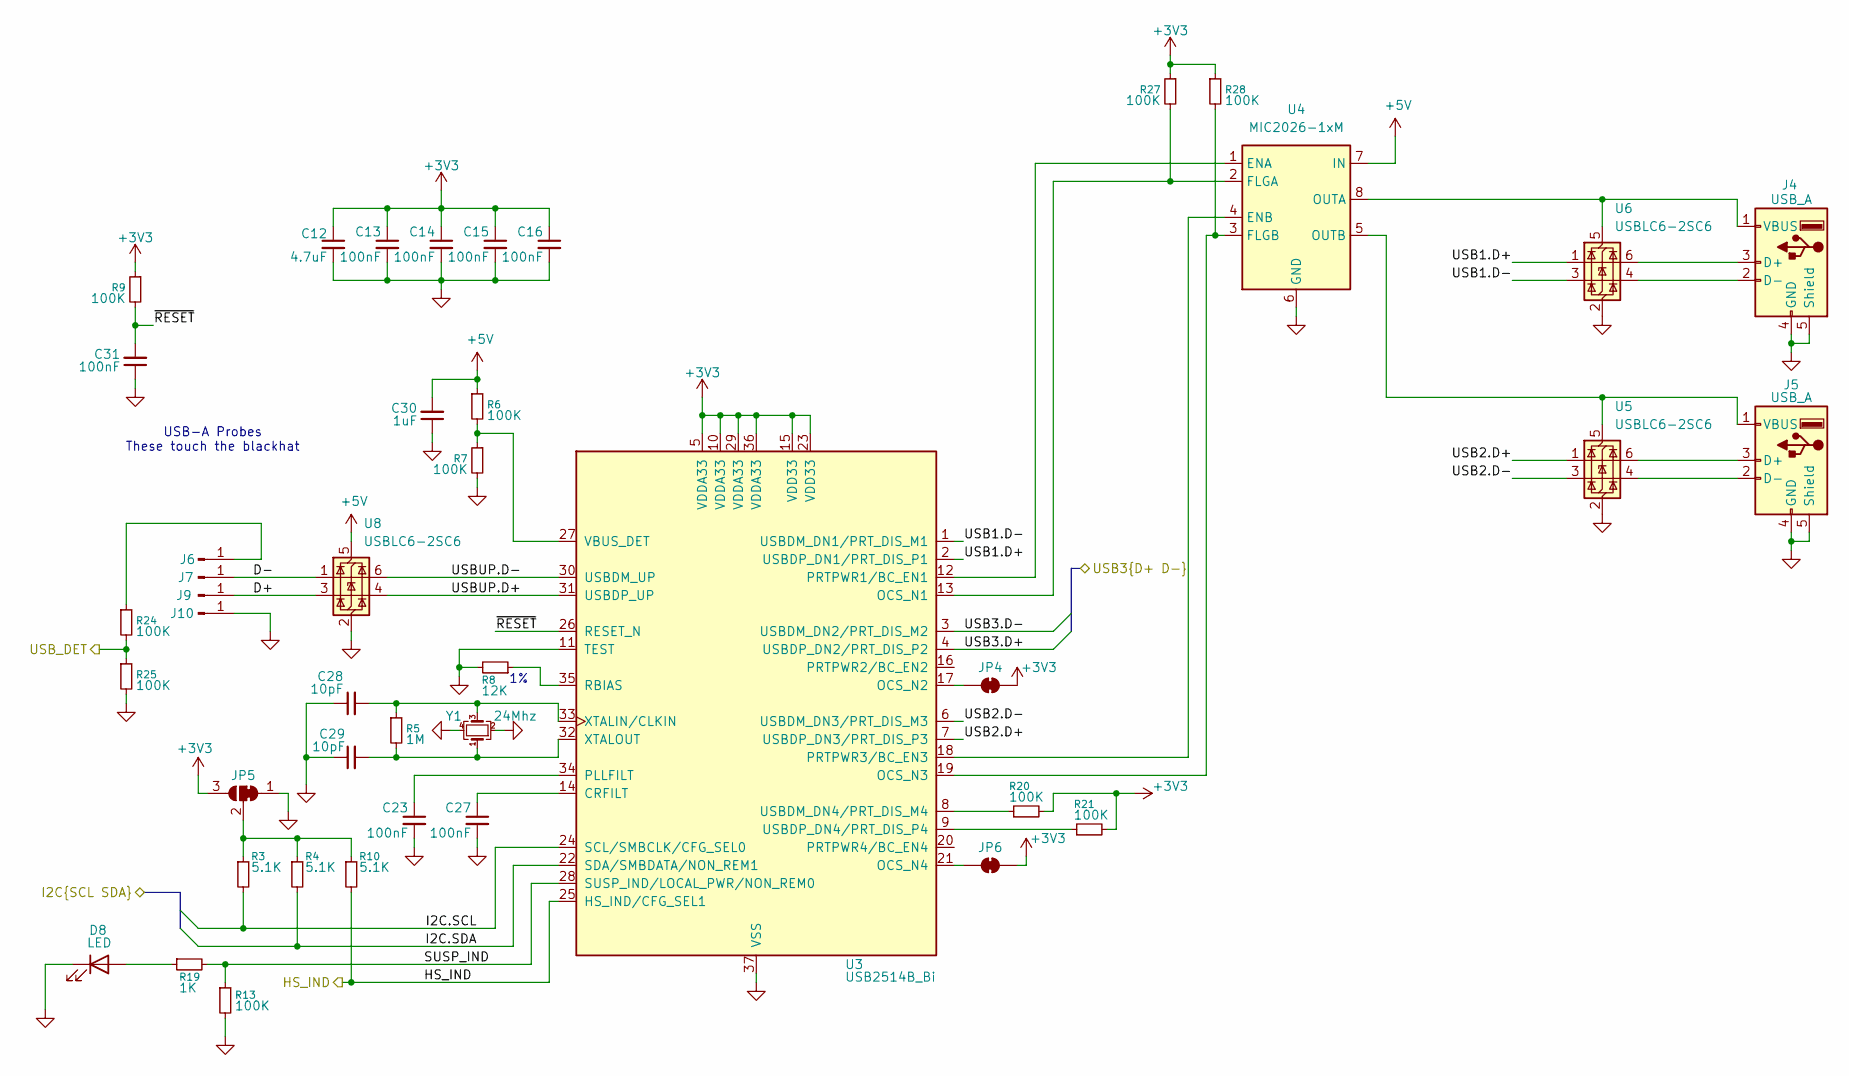
[picture p26: schematic usb.kicad_sch]

Parts:
C12: 4.7uF; C_0402_1005Metric; MPN CC0402MRX5R5BB475
C13, C14, C15, C16, C23, C27, C31: 100nF; C_0402_1005Metric; MPN CL05B104KB54PNC
C28, C29: 10pF; C_0402_1005Metric; MPN GRM1555C1H100FA01D
C30: 1uF; C_0402_1005Metric; MPN CL05B105KQ5NQNC
D8: LED; LED_0603_1608Metric; MPN KT-0603R
J4, J5: USB_A; USB_A_Receptacle_GCT_1; MPN USB1046-GF-0190-L-B-A
J6, J7, J9, J10: Conn_01x01_Pin; 1871059-1; MPN 1871059-1
JP4, JP6: SolderJumper_2_Bridged; SolderJumper-2_P1.3mm_Bridged_Pad1.0x1.5mm
JP5: SolderJumper_3_Bridged12; SolderJumper-3_P1.3mm_Bridged2Bar12_RoundedPad1.0x1.5mm
R3, R4, R10: 5.1K; R_0402_1005Metric; MPN RC0402FR-135K1L
R5: 1M; R_0402_1005Metric; MPN RC0402FR-131ML
R6, R7, R9, R13, R20, R21, R24, R25, R27, R28: 100K; R_0402_1005Metric; MPN RC0402FR-13100KL
R8: 12K; R_0402_1005Metric; MPN RC0402FR-1312KL
R19: 1K; R_0402_1005Metric; MPN 0402WGF1001TCE
U3: USB2514B_Bi; QFN-36-1EP_6x6mm_P0.5mm_EP3.7x3.7mm; MPN USB2514BI-AEZG-TR
U4: MIC2026-1xM; SOIC-8_3.9x4.9mm_P1.27mm; MPN MIC2026-1YM-TR
U5, U6, U8: USBLC6-2SC6; SOT-23-6; MPN USBLC6-2SC6
Y1: 24Mhz; Crystal_SMD_Citizen_CS325S-4Pin_3.2x2.5mm; MPN CS325S24000000ABJT

Connections:
+3V3: C12.1, C13.1, C14.1, C15.1, C16.1, JP4.2 (B), JP5.3 (B), JP6.2 (B), R9.1, R20.2, R21.2, R27.1, R28.1, U3.5 (VDDA33), U3.10 (VDDA33), U3.15 (VDD33), U3.23 (VDD33), U3.29 (VDDA33), U3.36 (VDDA33)
+5V: C30.2, R6.1, U4.7 (IN), U8.5 (VBUS)
D+: J9.1, U8.3 (I/O2)
D-: J7.1, U8.1 (I/O1)
GND: C12.2, C13.2, C14.2, C15.2, C16.2, C23.2, C27.2, C28.1, C29.1, C30.1, C31.1, D8.1 (K), J4.4 (GND), J4.5 (Shield), J5.4 (GND), J5.5 (Shield), J10.1, JP5.1 (A), R7.2, R8.2, R13.2, R25.2, U3.11 (TEST), U3.37 (VSS), U4.6 (GND), U5.2 (GND), U6.2 (GND), U8.2 (GND), Y1.2, Y1.4
HS_IND: R10.2, U3.25 (HS_IND/CFG_SEL1)
I2C.SCL: R3.2, U3.24 (SCL/SMBCLK/CFG_SEL0)
I2C.SDA: R4.2, U3.22 (SDA/SMBDATA/NON_REM1)
unnamed: C23.1, U3.34 (PLLFILT)
unnamed: C27.1, U3.14 (CRFILT)
unnamed: C28.2, R5.1, U3.33 (XTALIN/CLKIN), Y1.3
unnamed: C29.2, R5.2, U3.32 (XTALOUT), Y1.1
unnamed: D8.2 (A), R19.1
unnamed: J4.1 (VBUS), U4.8 (OUTA), U6.5 (VBUS)
unnamed: J4.2 (D-), U6.4 (I/O2)
unnamed: J4.3 (D+), U6.6 (I/O1)
unnamed: J5.1 (VBUS), U4.5 (OUTB), U5.5 (VBUS)
unnamed: J5.2 (D-), U5.4 (I/O2)
unnamed: J5.3 (D+), U5.6 (I/O1)
unnamed: J6.1, R24.1
unnamed: JP4.1 (A), U3.17 (OCS_N2)
unnamed: JP5.2 (C), R3.1, R4.1, R10.1
unnamed: JP6.1 (A), U3.21 (OCS_N4)
unnamed: R6.2, R7.1, U3.27 (VBUS_DET)
unnamed: R8.1, U3.35 (RBIAS)
unnamed: R20.1, U3.8 (USBDM_DN4/PRT_DIS_M4)
unnamed: R21.1, U3.9 (USBDP_DN4/PRT_DIS_P4)
unnamed: R27.2, U3.13 (OCS_N1), U4.2 (FLGA)
unnamed: R28.2, U3.19 (OCS_N3), U4.3 (FLGB)
unnamed: U3.12 (PRTPWR1/BC_EN1), U4.1 (ENA)
unnamed: U3.18 (PRTPWR3/BC_EN3), U4.4 (ENB)
SUSP_IND: R13.1, R19.2, U3.28 (SUSP_IND/LOCAL_PWR/NON_REM0)
USB1.D+: U3.2 (USBDP_DN1/PRT_DIS_P1), U6.1 (I/O1)
USB1.D-: U3.1 (USBDM_DN1/PRT_DIS_M1), U6.3 (I/O2)
USB2.D+: U3.7 (USBDP_DN3/PRT_DIS_P3), U5.1 (I/O1)
USB2.D-: U3.6 (USBDM_DN3/PRT_DIS_M3), U5.3 (I/O2)
USB3.D+: U3.4 (USBDP_DN2/PRT_DIS_P2)
USB3.D-: U3.3 (USBDM_DN2/PRT_DIS_M2)
USBUP.D+: U3.31 (USBDP_UP), U8.4 (I/O2)
USBUP.D-: U3.30 (USBDM_UP), U8.6 (I/O1)
USB_DET: R24.2, R25.1
~RESET: C31.2, R9.2, U3.26 (RESET_N)

Notes on the sheet:
USB-A Probes These touch the blackhat
