stanley-fork/Blackpants/ee/integrated/a33_power.kicad_sch

## KiCad design ee/integrated/a33_power.kicad_sch (2026-06-06)

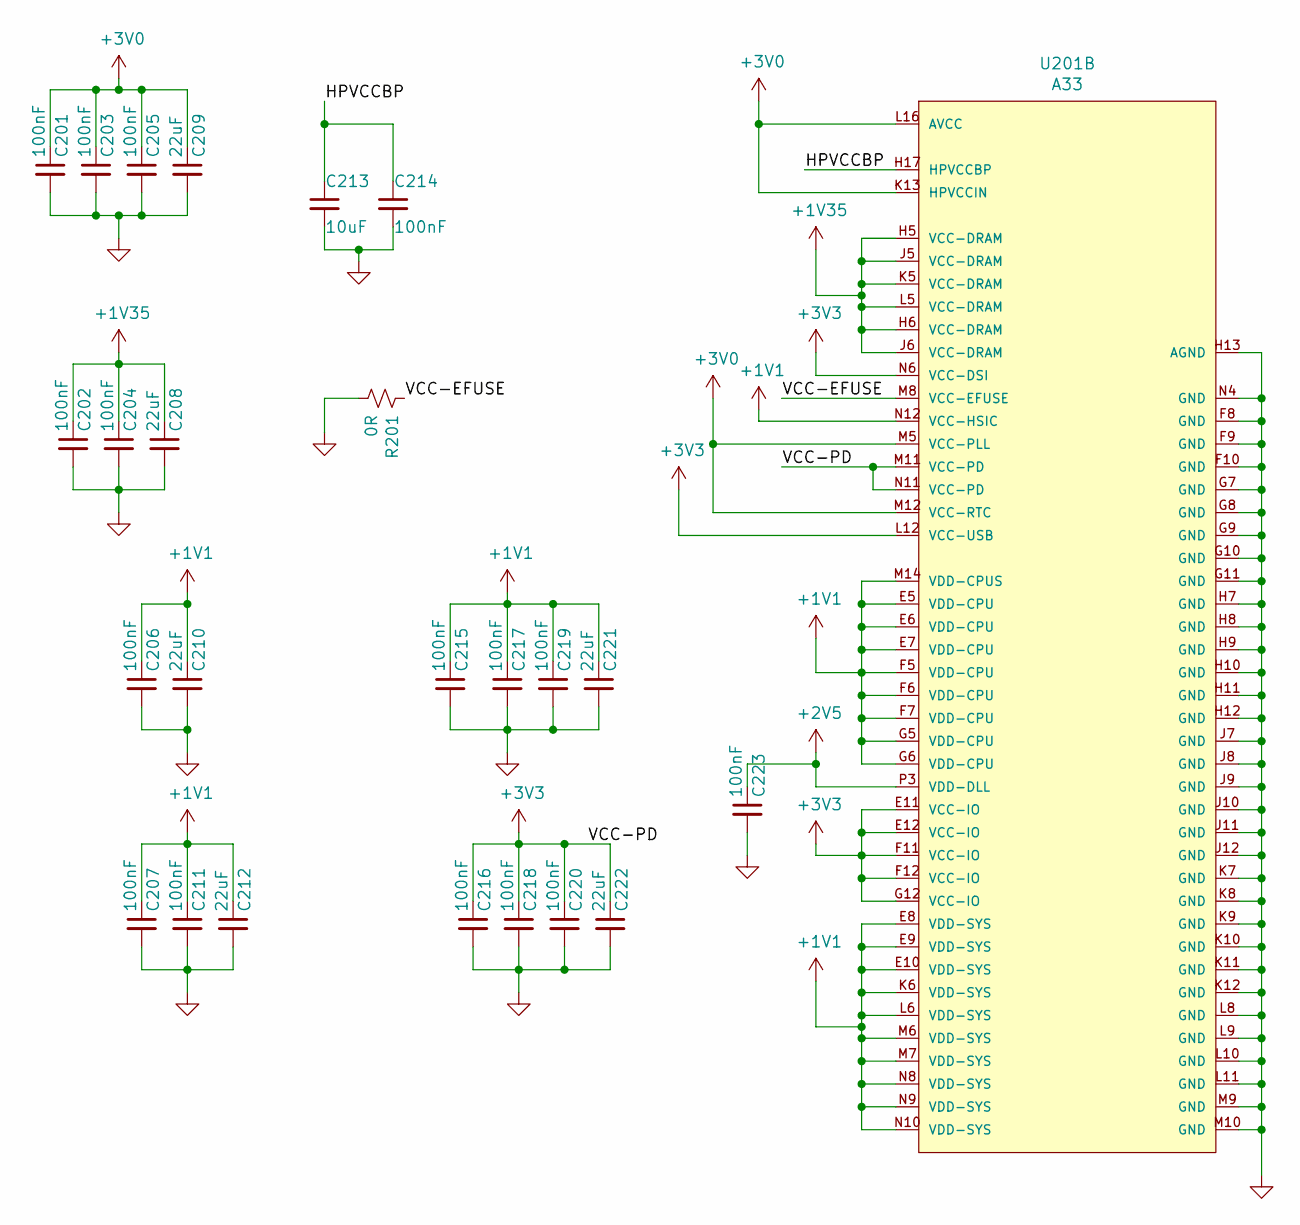
[picture p27: schematic a33_power.kicad_sch]

Parts:
C201, C202, C203, C204, C205, C206, C207, C211, C214, C215, C216, C217, C218, C219, C220, C223: 100nF; C_0402_1005Metric; MPN CC0402KRX7R7BB104
C208, C209, C210, C212, C221, C222: 22uF; C_0402_1005Metric; MPN GRM155R60J226ME11D
C213: 10uF; C_0402_1005Metric; MPN CL05A106MQ5NUNC
R201: 0R; R_0402_1005Metric; MPN RC0402JR-070RL
U201: A33; Allwinner_Technology_Co.,_Ltd.-A33-0; MPN "Allwinner A33" or "Allwinner R16"

Connections:
+1V1: C206.1, C207.1, C210.1, C211.1, C212.1, C215.1, C217.1, C219.1, C221.1, U201.E5 (VDD-CPU), U201.E6 (VDD-CPU), U201.E7 (VDD-CPU), U201.E8 (VDD-SYS), U201.E9 (VDD-SYS), U201.E10 (VDD-SYS), U201.F5 (VDD-CPU), U201.F6 (VDD-CPU), U201.F7 (VDD-CPU), U201.G5 (VDD-CPU), U201.G6 (VDD-CPU), U201.K6 (VDD-SYS), U201.L6 (VDD-SYS), U201.M6 (VDD-SYS), U201.M7 (VDD-SYS), U201.M14 (VDD-CPUS), U201.N8 (VDD-SYS), U201.N9 (VDD-SYS), U201.N10 (VDD-SYS), U201.N12 (VCC-HSIC)
+1V35: C202.1, C204.1, C208.1, U201.H5 (VCC-DRAM), U201.H6 (VCC-DRAM), U201.J5 (VCC-DRAM), U201.J6 (VCC-DRAM), U201.K5 (VCC-DRAM), U201.L5 (VCC-DRAM)
+2V5: C223.1, U201.P3 (VDD-DLL)
+3V0: C201.1, C203.1, C205.1, C209.1, U201.K13 (HPVCCIN), U201.L16 (AVCC), U201.M5 (VCC-PLL), U201.M12 (VCC-RTC)
+3V3: C216.1, C218.1, C220.1, C222.1, U201.E11 (VCC-IO), U201.E12 (VCC-IO), U201.F11 (VCC-IO), U201.F12 (VCC-IO), U201.G12 (VCC-IO), U201.L12 (VCC-USB), U201.M11 (VCC-PD), U201.N6 (VCC-DSI), U201.N11 (VCC-PD)
GND: C201.2, C202.2, C203.2, C204.2, C205.2, C206.2, C207.2, C208.2, C209.2, C210.2, C211.2, C212.2, C213.2, C214.2, C215.2, C216.2, C217.2, C218.2, C219.2, C220.2, C221.2, C222.2, C223.2, R201.2, U201.F8 (GND), U201.F9 (GND), U201.F10 (GND), U201.G7 (GND), U201.G8 (GND), U201.G9 (GND), U201.G10 (GND), U201.G11 (GND), U201.H7 (GND), U201.H8 (GND), U201.H9 (GND), U201.H10 (GND), U201.H11 (GND), U201.H12 (GND), U201.H13 (AGND), U201.J7 (GND), U201.J8 (GND), U201.J9 (GND), U201.J10 (GND), U201.J11 (GND), U201.J12 (GND), U201.K7 (GND), U201.K8 (GND), U201.K9 (GND), U201.K10 (GND), U201.K11 (GND), U201.K12 (GND), U201.L8 (GND), U201.L9 (GND), U201.L10 (GND), U201.L11 (GND), U201.M9 (GND), U201.M10 (GND), U201.N4 (GND)
HPVCCBP: C213.1, C214.1, U201.H17 (HPVCCBP)
VCC-EFUSE: R201.1, U201.M8 (VCC-EFUSE)
