stanley-fork/Blackpants/ee/integrated/a33_ram.kicad_sch

## KiCad design ee/integrated/a33_ram.kicad_sch (2026-06-06)

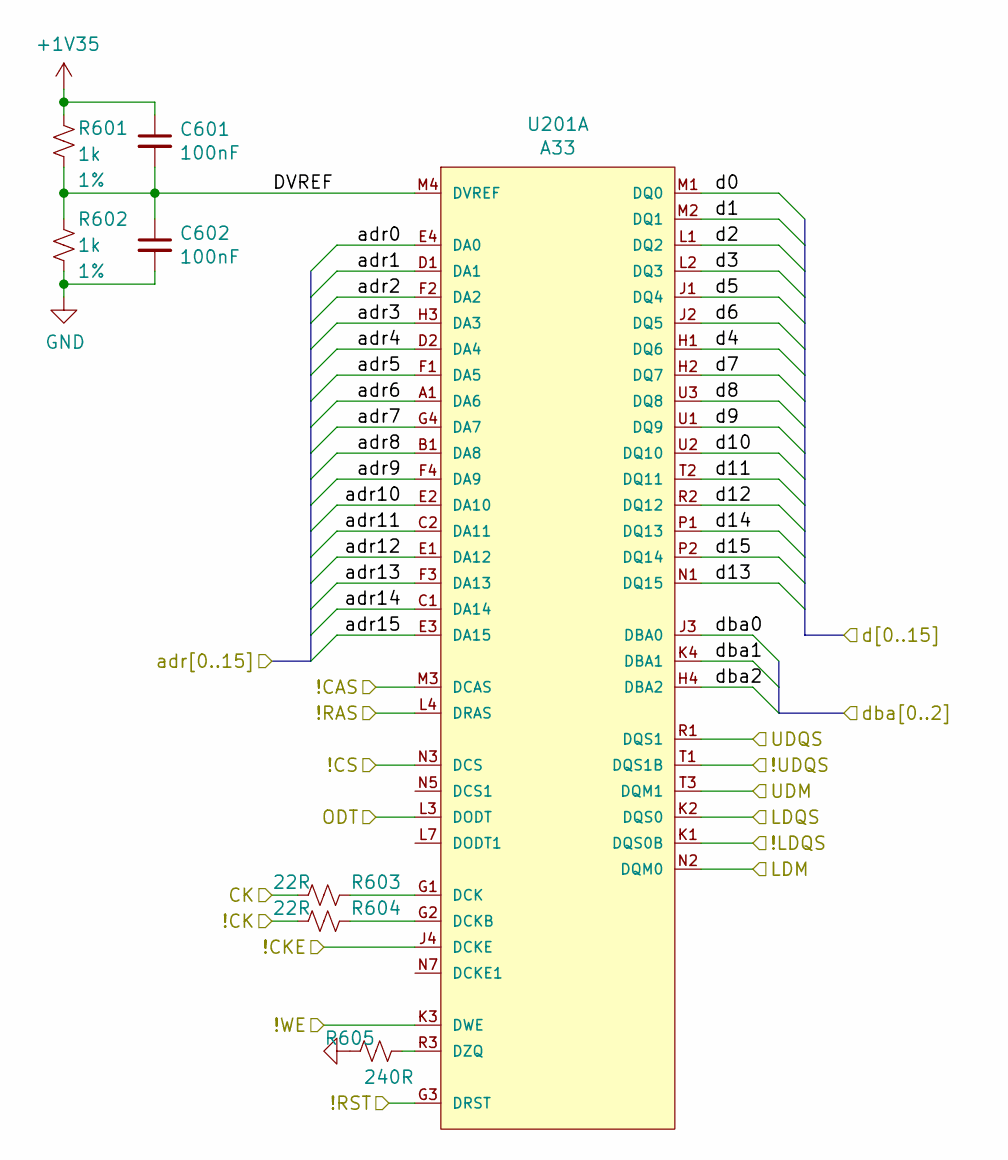
[picture p28: schematic a33_ram.kicad_sch]

Parts:
C601, C602: 100nF; C_0402_1005Metric; MPN CC0402KRX7R7BB104
R601, R602: 1k; R_0402_1005Metric; Tolerance 1%; MPN RT0402BRD071KL
R603, R604: 22R; R_0402_1005Metric; MPN RC0402JR-0722RL
R605: 240R; R_0402_1005Metric; MPN 0402WGF2400TCE
U201: A33; Allwinner_Technology_Co.,_Ltd.-A33-0; MPN "Allwinner A33" or "Allwinner R16"

Connections:
!CAS: U201.M3 (DCAS)
!CK: R604.2
!CKE: U201.J4 (DCKE)
!CS: U201.N3 (DCS)
!LDQS: U201.K1 (DQS0B)
!RAS: U201.L4 (DRAS)
!RST: U201.G3 (DRST)
!UDQS: U201.T1 (DQS1B)
!WE: U201.K3 (DWE)
+1V35: C601.1, R601.1
CK: R603.2
DVREF: C601.2, C602.1, R601.2, R602.1, U201.M4 (DVREF)
GND: C602.2, R602.2, R605.2
LDM: U201.N2 (DQM0)
LDQS: U201.K2 (DQS0)
unnamed: R603.1, U201.G1 (DCK)
unnamed: R604.1, U201.G2 (DCKB)
unnamed: R605.1, U201.R3 (DZQ)
ODT: U201.L3 (DODT)
UDM: U201.T3 (DQM1)
UDQS: U201.R1 (DQS1)
adr0: U201.E4 (DA0)
adr1: U201.D1 (DA1)
adr2: U201.F2 (DA2)
adr3: U201.H3 (DA3)
adr4: U201.D2 (DA4)
adr5: U201.F1 (DA5)
adr6: U201.A1 (DA6)
adr7: U201.G4 (DA7)
adr8: U201.B1 (DA8)
adr9: U201.F4 (DA9)
adr10: U201.E2 (DA10)
adr11: U201.C2 (DA11)
adr12: U201.E1 (DA12)
adr13: U201.F3 (DA13)
adr14: U201.C1 (DA14)
adr15: U201.E3 (DA15)
d0: U201.M1 (DQ0)
d1: U201.M2 (DQ1)
d2: U201.L1 (DQ2)
d3: U201.L2 (DQ3)
d4: U201.H1 (DQ6)
d5: U201.J1 (DQ4)
d6: U201.J2 (DQ5)
d7: U201.H2 (DQ7)
d8: U201.U3 (DQ8)
d9: U201.U1 (DQ9)
d10: U201.U2 (DQ10)
d11: U201.T2 (DQ11)
d12: U201.R2 (DQ12)
d13: U201.N1 (DQ15)
d14: U201.P1 (DQ13)
d15: U201.P2 (DQ14)
dba0: U201.J3 (DBA0)
dba1: U201.K4 (DBA1)
dba2: U201.H4 (DBA2)
