stanley-fork/Blackpants/ee/integrated/dsi.kicad_sch

## KiCad design ee/integrated/dsi.kicad_sch (2026-06-06)

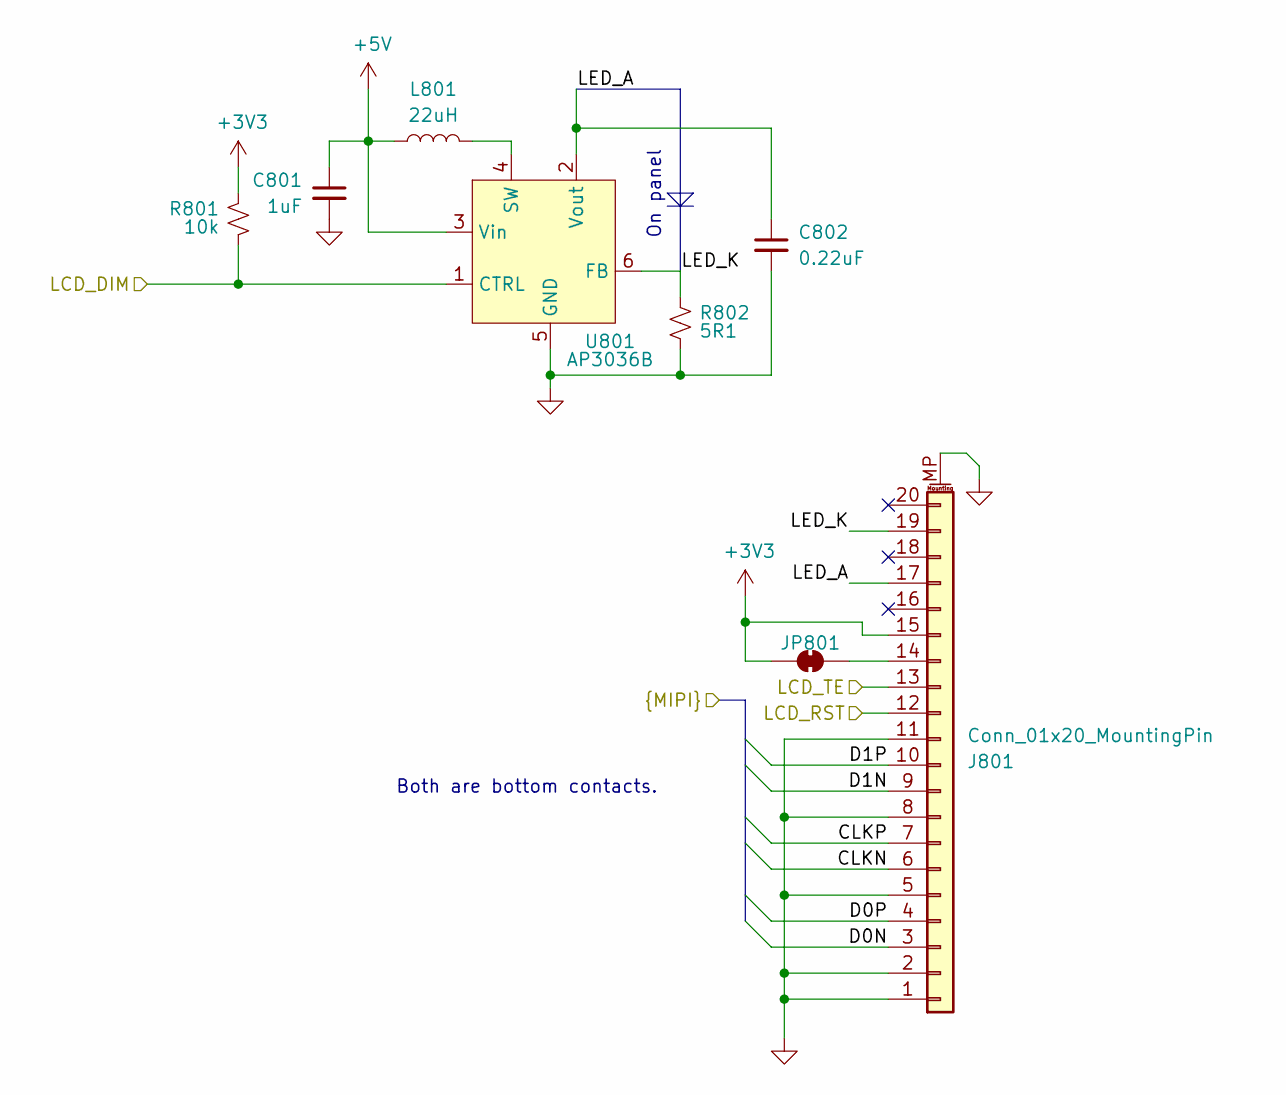
[picture p29: schematic dsi.kicad_sch]

Parts:
C801: 1uF; C_0402_1005Metric; MPN CL05A105KO5NNNC
C802: 0.22uF; C_0603_1608Metric; MPN CC0603KRX7R7BB224
J801: Conn_01x20_MountingPin; Hirose_FH12-20S-0.5SH_1x20-1MP_P0.50mm_Horizontal; MPN FH12-20S-0.5SH(55)
JP801: SolderJumper_2_Bridged; SolderJumper-2_P1.3mm_Bridged_Pad1.0x1.5mm
L801: 22uH; L_1210_3225Metric; MPN CBC3225T220MR
R801: 10k; R_0402_1005Metric; MPN RC0402JR-0710KL
R802: 5R1; R_0402_1005Metric; MPN RC0402JR-075R1L
U801: AP3036B; SOT-23-6; MPN AP3036BKTR-G1

Connections:
+3V3: J801.15, JP801.1 (A), R801.1
+5V: C801.1, L801.1, U801.3 (Vin)
CLKN: J801.6
CLKP: J801.7
D0N: J801.3
D0P: J801.4
D1N: J801.9
D1P: J801.10
GND: C801.2, C802.2, J801.1, J801.2, J801.5, J801.8, J801.11, J801.MP (MountPin), R802.2, U801.5 (GND)
LCD_DIM: R801.2, U801.1 (CTRL)
LCD_RST: J801.12
LCD_TE: J801.13
LED_A: C802.1, J801.17, U801.2 (Vout)
LED_K: J801.19, R802.1, U801.6 (FB)
unnamed: J801.14, JP801.2 (B)
unnamed: L801.2, U801.4 (SW)

Notes on the sheet:
Both are bottom contacts.
On panel
