stanley-fork/Blackpants/ee/integrated/gpio.kicad_sch

## KiCad design ee/integrated/gpio.kicad_sch (2026-06-06)

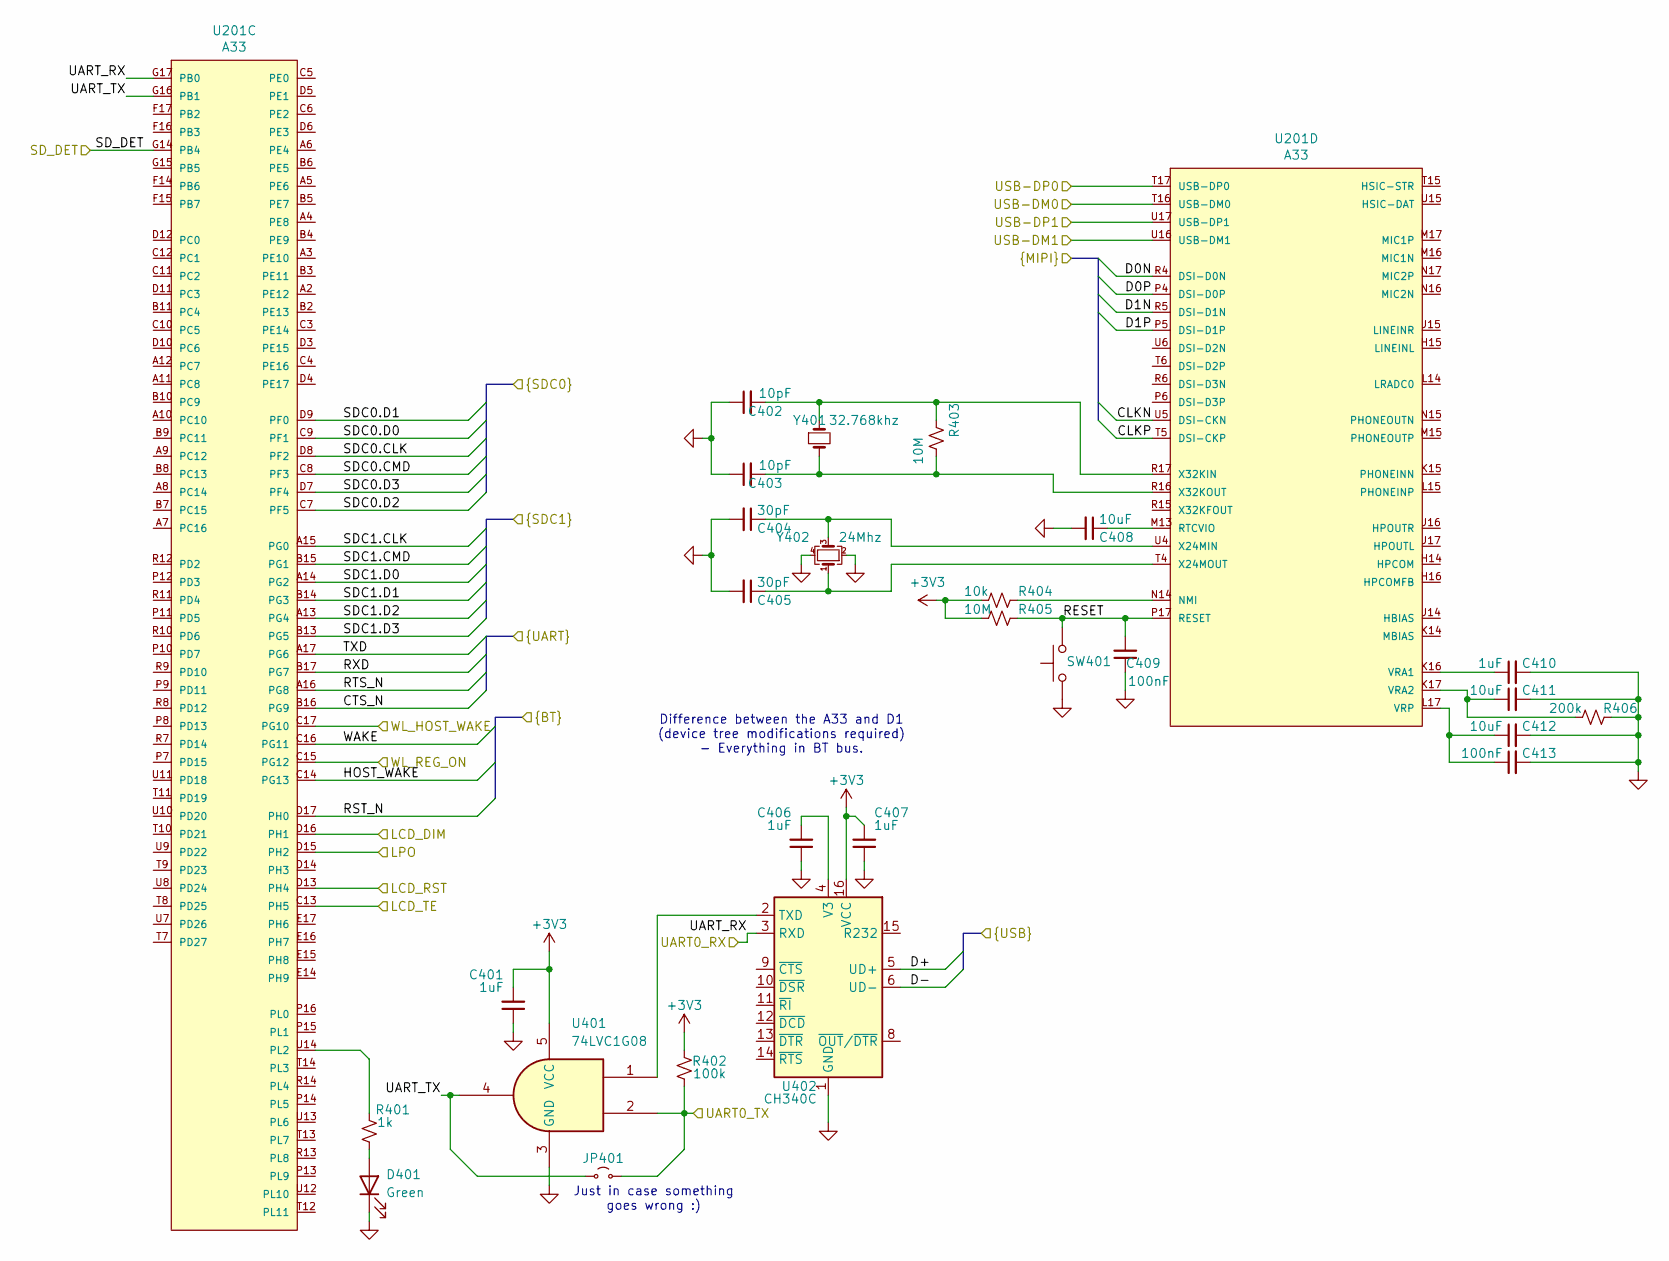
[picture p30: schematic gpio.kicad_sch]

Parts:
C401, C406, C407, C410: 1uF; C_0402_1005Metric; MPN CL05A105KO5NNNC
C402, C403: 10pF; C_0402_1005Metric; MPN CC0402JRNPO9BN100
C404, C405: 30pF; C_0402_1005Metric; MPN CC0402JRNPO9BN300
C408, C411, C412: 10uF; C_0402_1005Metric; MPN CL05A106MQ5NUNC
C409, C413: 100nF; C_0402_1005Metric; MPN CC0402KRX7R7BB104
D401: Green; LED_0603_1608Metric; MPN LTST-C193TGKT-5A
JP401: Jumper_2_Small_Open; SolderJumper-2_P1.3mm_Open_RoundedPad1.0x1.5mm
R401: 1k; R_0402_1005Metric; MPN RC0402JR-071KL
R402: 100k; R_0402_1005Metric; MPN RC0402FR-13100KL
R403, R405: 10M; R_0402_1005Metric; MPN 0402WGJ0106TCE
R404: 10k; R_0402_1005Metric; MPN RC0402JR-0710KL
R406: 200k; R_0402_1005Metric; MPN RC0402FR-07200KL
SW401: SW_Push; SW_SPST_TL3305A; MPN TL3305AF260QG
U201: A33; Allwinner_Technology_Co.,_Ltd.-A33-0; MPN "Allwinner A33" or "Allwinner R16"
U401: 74LVC1G08; SOT-353_SC-70-5; MPN SN74LVC1G08DCKR
U402: CH340C; SOIC-16_3.9x9.9mm_P1.27mm; MPN CH340C
Y401: 32.768khz; Abracon-ABS05-0-0-MFG; MPN ABS05-32.768KHZ-9-T
Y402: 24Mhz; Crystal_SMD_Abracon_ABM8G-4Pin_3.2x2.5mm; MPN ABM8G-24.000MHZ-18-D2Y-T

Connections:
+3V3: C401.2, C407.2, R402.2, R404.2, R405.2, U401.5 (VCC), U402.16 (VCC)
CLKN: U201.U5 (DSI-CKN)
CLKP: U201.T5 (DSI-CKP)
CTS_N: U201.B16 (PG9)
D0N: U201.R4 (DSI-D0N)
D0P: U201.P4 (DSI-D0P)
D1N: U201.R5 (DSI-D1N)
D1P: U201.P5 (DSI-D1P)
D+: U402.5 (UD+)
D-: U402.6 (UD-)
GND: C401.1, C402.1, C403.1, C404.2, C405.2, C406.1, C407.1, C408.2, C409.1, C410.2, C411.2, C412.2, C413.2, D401.1 (K), R406.1, SW401.1, U401.3 (GND), U402.1 (GND), Y402.2, Y402.4
HOST_WAKE: U201.C14 (PG13)
LCD_DIM: U201.D16 (PH1)
LCD_RST: U201.D13 (PH4)
LCD_TE: U201.C13 (PH5)
LPO: U201.D15 (PH2)
unnamed: C402.2, R403.1, U201.R17 (X32KIN), Y401.1
unnamed: C403.2, R403.2, U201.R16 (X32KOUT), Y401.2
unnamed: C404.1, U201.U4 (X24MIN), Y402.3
unnamed: C405.1, U201.T4 (X24MOUT), Y402.1
unnamed: C406.2, U402.4 (V3)
unnamed: C408.1, U201.M13 (RTCVIO)
unnamed: C410.1, U201.K16 (VRA1)
unnamed: C411.1, R406.2, U201.K17 (VRA2)
unnamed: C412.1, C413.1, U201.L17 (VRP)
unnamed: D401.2 (A), R401.2
unnamed: R401.1, U201.U14 (PL2)
unnamed: R404.1, U201.N14 (NMI)
unnamed: U401.1, U402.2 (TXD)
RESET: C409.2, R405.1, SW401.2, U201.P17 (RESET)
RST_N: U201.D17 (PH0)
RTS_N: U201.A16 (PG8)
RXD: U201.B17 (PG7)
SDC0.CLK: U201.D8 (PF2)
SDC0.CMD: U201.C8 (PF3)
SDC0.D0: U201.C9 (PF1)
SDC0.D1: U201.D9 (PF0)
SDC0.D2: U201.C7 (PF5)
SDC0.D3: U201.D7 (PF4)
SDC1.CLK: U201.A15 (PG0)
SDC1.CMD: U201.B15 (PG1)
SDC1.D0: U201.A14 (PG2)
SDC1.D1: U201.B14 (PG3)
SDC1.D2: U201.A13 (PG4)
SDC1.D3: U201.B13 (PG5)
SD_DET: U201.G14 (PB4)
TXD: U201.A17 (PG6)
UART0_RX: U201.G17 (PB0), U402.3 (RXD)
UART0_TX: JP401.2 (B), R402.1, U401.2
UART_TX: JP401.1 (A), U201.G16 (PB1), U401.4
USB-DM0: U201.T16 (USB-DM0)
USB-DM1: U201.U16 (USB-DM1)
USB-DP0: U201.T17 (USB-DP0)
USB-DP1: U201.U17 (USB-DP1)
WAKE: U201.C16 (PG11)
WL_HOST_WAKE: U201.C17 (PG10)
WL_REG_ON: U201.C15 (PG12)

Notes on the sheet:
Just in case something goes wrong :)
Difference between the A33 and D1 (device tree modifications required) - Everything in BT bus.
