stanley-fork/Blackpants/ee/integrated/hardware.kicad_sch

## KiCad design ee/integrated/hardware.kicad_sch (2026-06-06)

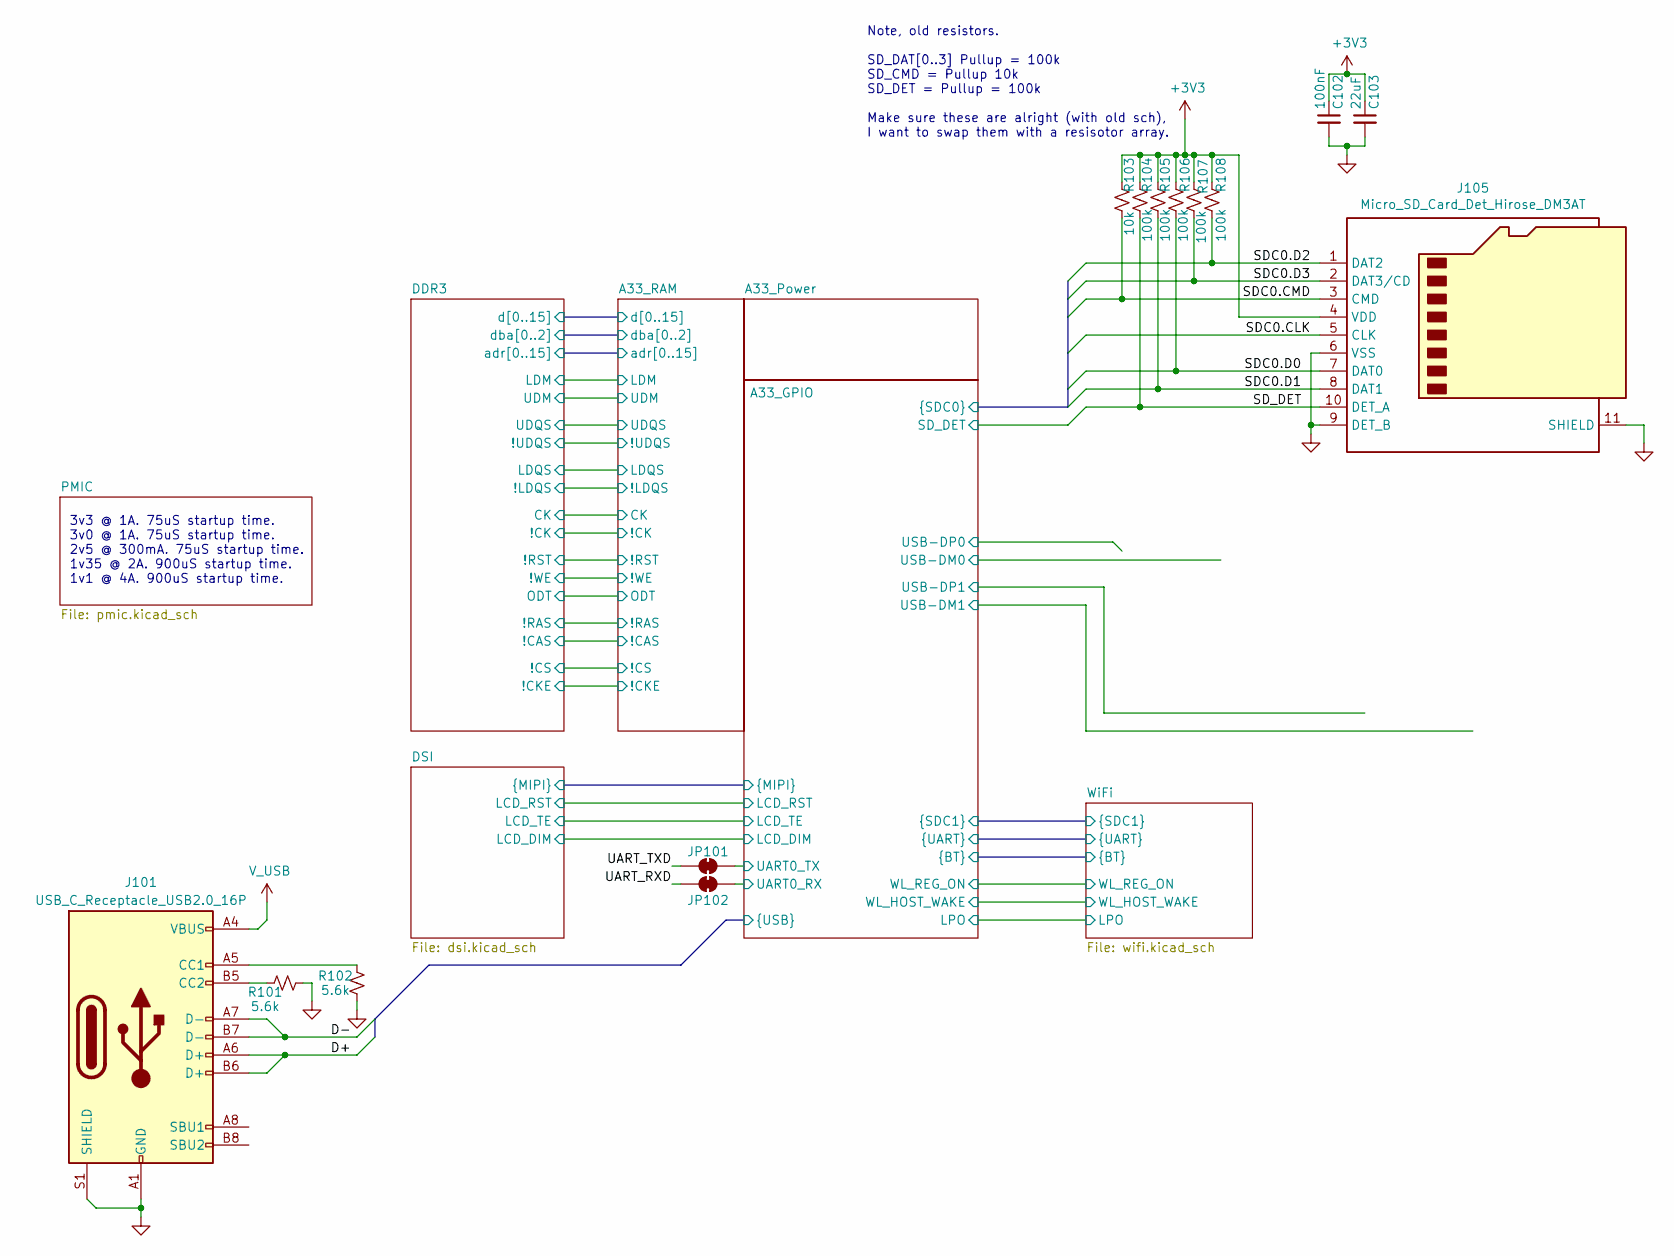
[picture p31: schematic hardware.kicad_sch]

Parts:
C102: 100nF; C_0402_1005Metric; MPN CC0402KRX7R7BB104
C103: 22uF; C_0402_1005Metric; MPN GRM155R60J226ME11D
J101: USB_C_Receptacle_USB2.0_16P; USB_C_Receptacle_GCT_USB4105-xx-A_16P_TopMnt_Horizontal; MPN USB4105-GF-A-120
J105: Micro_SD_Card_Det_Hirose_DM3AT; microSD_HC_Hirose_DM3AT-SF-PEJM5; MPN DM3AT-SF-PEJM5
JP101, JP102: SolderJumper_2_Bridged; SolderJumper-2_P1.3mm_Bridged_Pad1.0x1.5mm
R101, R102: 5.6k; R_0402_1005Metric; MPN RC0402FR-135K6L
R103: 10k; R_0402_1005Metric; MPN RC0402JR-0710KL
R104, R105, R106, R107, R108: 100k; R_0402_1005Metric; MPN RC0402FR-13100KL

Connections:
+3V3: C102.1, C103.1, J105.4 (VDD), R103.2, R104.2, R105.2, R106.2, R107.2, R108.2
D+: J101.A6 (D+), J101.B6 (D+)
D-: J101.A7 (D-), J101.B7 (D-)
GND: C102.2, C103.2, J101.A1 (GND), J101.A12 (GND), J101.B1 (GND), J101.B12 (GND), J101.S1 (SHIELD), J105.6 (VSS), J105.9 (DET_B), J105.11 (SHIELD), R101.1, R102.1
unnamed: J101.A5 (CC1), R102.2
unnamed: J101.B5 (CC2), R101.2
SDC0.CLK: J105.5 (CLK)
SDC0.CMD: J105.3 (CMD), R103.1
SDC0.D0: J105.7 (DAT0), R106.1
SDC0.D1: J105.8 (DAT1), R105.1
SDC0.D2: J105.1 (DAT2), R108.1
SDC0.D3: J105.2 (DAT3/CD), R107.1
SD_DET: J105.10 (DET_A), R104.1
UART0_RX: JP102.1 (A)
UART0_TX: JP101.1 (A)
UART_RXD: JP102.2 (B)
UART_TXD: JP101.2 (B)
V_USB: J101.A4 (VBUS), J101.A9 (VBUS), J101.B4 (VBUS), J101.B9 (VBUS)

Notes on the sheet:
Note, old resistors. SD_DAT[0..3] Pullup = 100k SD_CMD = Pullup 10k SD_DET = Pullup = 100k Make sure these are alright (with old sch), I want to swap them with a resisotor array.
3v3 @ 1A. 75uS startup time. 3v0 @ 1A. 75uS startup time. 2v5 @ 300mA. 75uS startup time. 1v35 @ 2A. 900uS startup time. 1v1 @ 4A. 900uS startup time.
