stanley-fork/Blackpants/ee/integrated/pmic.kicad_sch

## KiCad design ee/integrated/pmic.kicad_sch (2026-06-06)

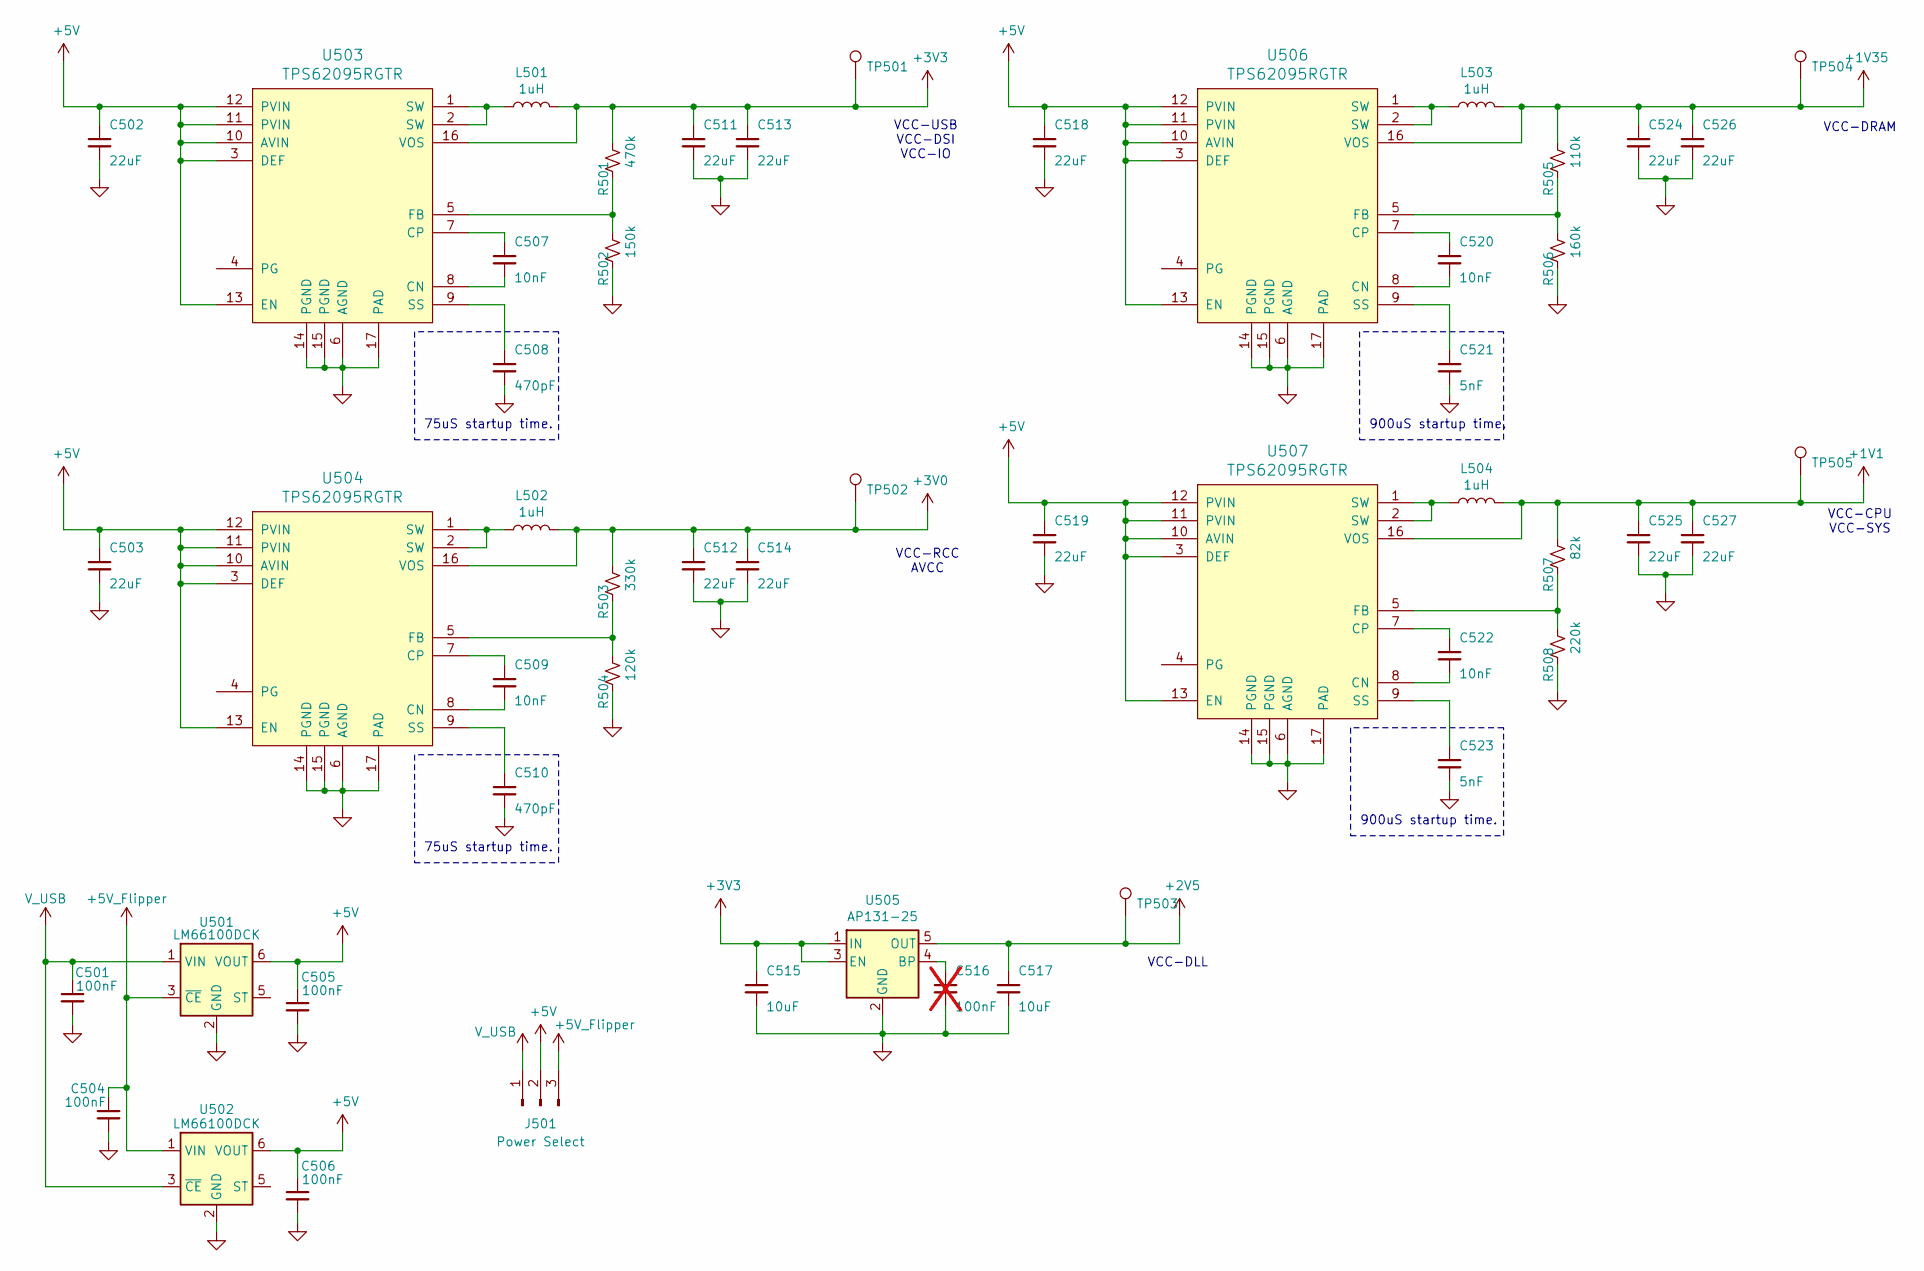
[picture p32: schematic pmic.kicad_sch]

Parts:
C501, C504, C505, C506: 100nF; C_0402_1005Metric; MPN CC0402KRX7R7BB104
C502, C503, C511, C512, C513, C514, C518, C519, C524, C525, C526, C527: 22uF; C_0805_2012Metric; MPN CL21A226MQQNNNE
C507, C509, C520, C522: 10nF; C_0402_1005Metric; MPN CL05B103KB5NNNC
C508, C510: 470pF; C_0402_1005Metric; MPN CL05B471KB5NNNC
C515, C517: 10uF; C_0805_2012Metric; MPN GRM21BR70J106KE76L
C516: 100nF; C_0402_1005Metric; MPN CC0402KRX7R7BB104; not fitted
C521, C523: 5nF; C_0402_1005Metric; MPN CC0402KRX7R9BB562
J501: Power Select; PinHeader_1x03_P2.54mm_Vertical
L501, L502, L503, L504: 1uH; SNH.4020.TYB1R0MT00; MPN SNH.4020.TYB1R0MT00
R501: 470k; R_0402_1005Metric; MPN RTT024703FTH
R502: 150k; R_0402_1005Metric; MPN RC0402FR-07150KL
R503: 330k; R_0402_1005Metric; MPN RC0402FR-07330KL
R504: 120k; R_0402_1005Metric; MPN RTT021203FTH
R505: 110k; R_0402_1005Metric; MPN RTT021103FTH
R506: 160k; R_0402_1005Metric; MPN 0402WGF1603TCE
R507: 82k; R_0402_1005Metric; MPN 0402WGF8202TCE
R508: 220k; R_0402_1005Metric; MPN ERJPA2F2203X
TP501, TP502, TP503, TP504, TP505: TestPoint; TestPoint_Pad_1.0x1.0mm
U501, U502: LM66100DCK; SOT-363_SC-70-6; MPN LM66100DCKR
U503, U504, U506, U507: TPS62095RGTR; TI_RTE_S-PWQFN-N16; MPN TPS62095RGTR
U505: AP131-25; SOT-23-5; MPN AP7331-25WG-7

Connections:
+1V1: C525.1, C527.1, L504.2, R507.1, TP505.1, U507.16 (VOS)
+1V35: C524.1, C526.1, L503.2, R505.1, TP504.1, U506.16 (VOS)
+2V5: C517.1, TP503.1, U505.5 (OUT)
+3V0: C512.1, C514.1, L502.2, R503.1, TP502.1, U504.16 (VOS)
+3V3: C511.1, C513.1, C515.1, L501.2, R501.1, TP501.1, U503.16 (VOS), U505.1 (IN), U505.3 (EN)
+5V: C502.1, C503.1, C505.1, C506.1, C518.1, C519.1, J501.2, U501.6 (VOUT), U502.6 (VOUT), U503.3 (DEF), U503.10 (AVIN), U503.11 (PVIN), U503.12 (PVIN), U503.13 (EN), U504.3 (DEF), U504.10 (AVIN), U504.11 (PVIN), U504.12 (PVIN), U504.13 (EN), U506.3 (DEF), U506.10 (AVIN), U506.11 (PVIN), U506.12 (PVIN), U506.13 (EN), U507.3 (DEF), U507.10 (AVIN), U507.11 (PVIN), U507.12 (PVIN), U507.13 (EN)
+5V_Flipper: C504.1, J501.3, U501.3 (~CE), U502.1 (VIN)
GND: C501.2, C502.2, C503.2, C504.2, C505.2, C506.2, C508.2, C510.2, C511.2, C512.2, C513.2, C514.2, C515.2, C516.2, C517.2, C518.2, C519.2, C521.2, C523.2, C524.2, C525.2, C526.2, C527.2, R502.2, R504.2, R506.2, R508.2, U501.2 (GND), U502.2 (GND), U503.6 (AGND), U503.14 (PGND), U503.15 (PGND), U503.17 (PAD), U504.6 (AGND), U504.14 (PGND), U504.15 (PGND), U504.17 (PAD), U505.2 (GND), U506.6 (AGND), U506.14 (PGND), U506.15 (PGND), U506.17 (PAD), U507.6 (AGND), U507.14 (PGND), U507.15 (PGND), U507.17 (PAD)
unnamed: C507.1, U503.7 (CP)
unnamed: C507.2, U503.8 (CN)
unnamed: C508.1, U503.9 (SS)
unnamed: C509.1, U504.7 (CP)
unnamed: C509.2, U504.8 (CN)
unnamed: C510.1, U504.9 (SS)
unnamed: C516.1, U505.4 (BP)
unnamed: C520.1, U506.7 (CP)
unnamed: C520.2, U506.8 (CN)
unnamed: C521.1, U506.9 (SS)
unnamed: C522.1, U507.7 (CP)
unnamed: C522.2, U507.8 (CN)
unnamed: C523.1, U507.9 (SS)
unnamed: L501.1, U503.1 (SW), U503.2 (SW)
unnamed: L502.1, U504.1 (SW), U504.2 (SW)
unnamed: L503.1, U506.1 (SW), U506.2 (SW)
unnamed: L504.1, U507.1 (SW), U507.2 (SW)
unnamed: R501.2, R502.1, U503.5 (FB)
unnamed: R503.2, R504.1, U504.5 (FB)
unnamed: R505.2, R506.1, U506.5 (FB)
unnamed: R507.2, R508.1, U507.5 (FB)
V_USB: C501.1, J501.1, U501.1 (VIN), U502.3 (~CE)

Notes on the sheet:
900uS startup time.
VCC-DRAM
VCC-USB VCC-DSI VCC-IO
VCC-CPU VCC-SYS
VCC-RCC AVCC
75uS startup time.
VCC-DLL
