stanley-fork/Blackpants/ee/integrated/ram.kicad_sch

## KiCad design ee/integrated/ram.kicad_sch (2026-06-06)

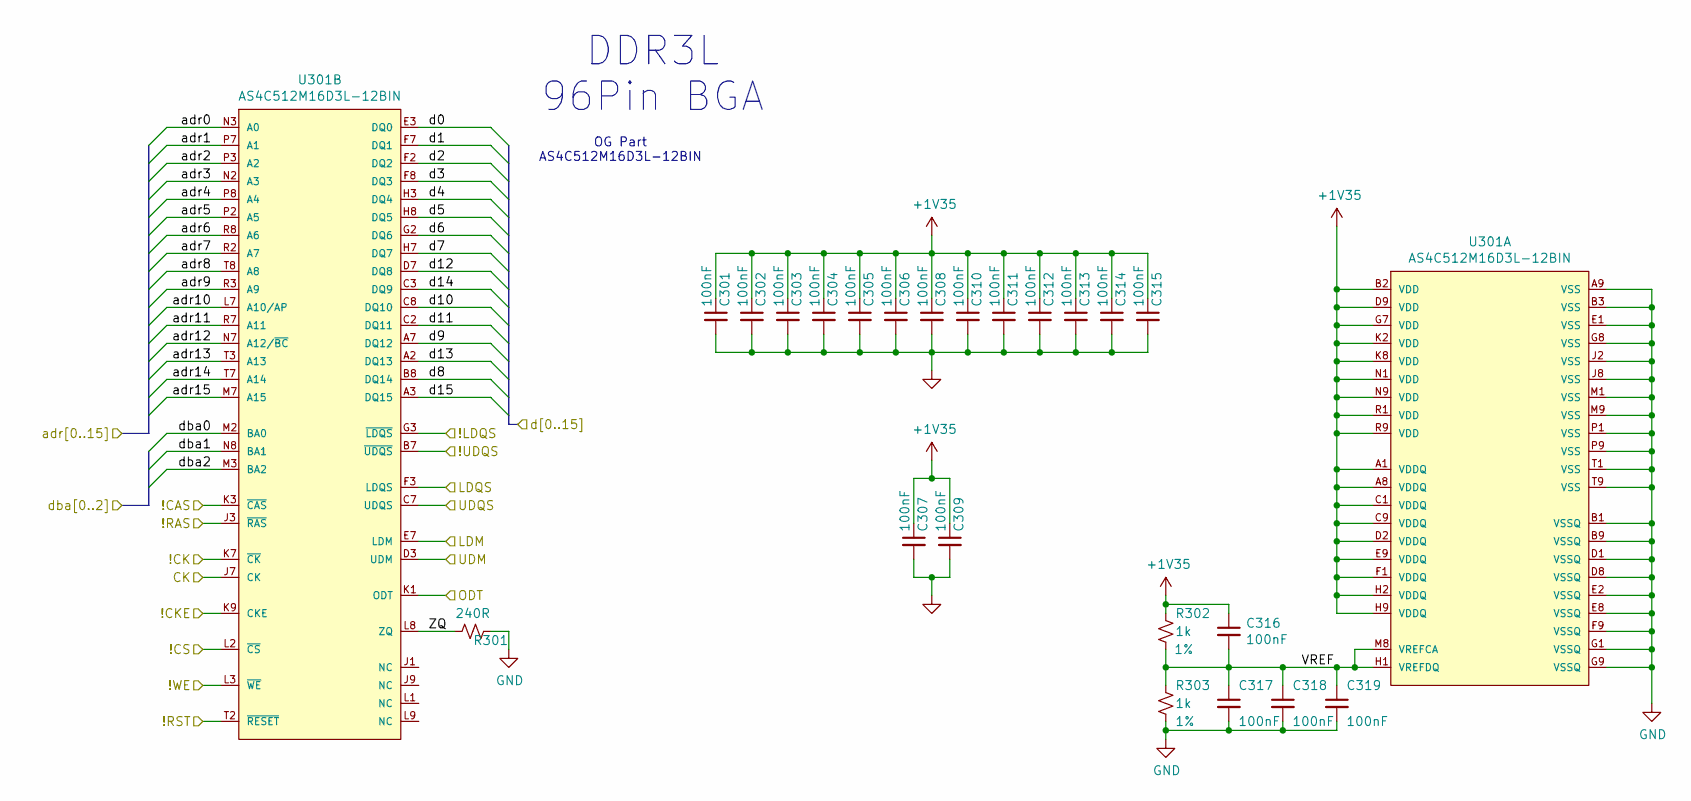
[picture p33: schematic ram.kicad_sch]

Parts:
C301, C302, C303, C304, C305, C306, C307, C308, C309, C310, C311, C312, C313, C314, C315, C316, C317, C318, C319: 100nF; C_0402_1005Metric; MPN CC0402KRX7R7BB104
R301: 240R; R_0402_1005Metric; MPN 0402WGF2400TCE
R302, R303: 1k; R_0402_1005Metric; Tolerance 1%; MPN RT0402BRD071KL
U301: AS4C512M16D3L-12BIN; Alliance_Memory-AS4C512M16D3L-12BIN-0-0-IPC_A; MPN ZDV4256M16A-13DPH

Connections:
!CAS: U301.K3 (~CAS)
!CK: U301.K7 (~CK)
!CKE: U301.K9 (CKE)
!CS: U301.L2 (~CS)
!LDQS: U301.G3 (~LDQS)
!RAS: U301.J3 (~RAS)
!RST: U301.T2 (~RESET)
!UDQS: U301.B7 (~UDQS)
!WE: U301.L3 (~WE)
+1V35: C301.1, C302.1, C303.1, C304.1, C305.1, C306.1, C307.1, C308.1, C309.1, C310.1, C311.1, C312.1, C313.1, C314.1, C315.1, C316.1, R302.1, U301.A1 (VDDQ), U301.A8 (VDDQ), U301.B2 (VDD), U301.C1 (VDDQ), U301.C9 (VDDQ), U301.D2 (VDDQ), U301.D9 (VDD), U301.E9 (VDDQ), U301.F1 (VDDQ), U301.G7 (VDD), U301.H2 (VDDQ), U301.H9 (VDDQ), U301.K2 (VDD), U301.K8 (VDD), U301.N1 (VDD), U301.N9 (VDD), U301.R1 (VDD), U301.R9 (VDD)
CK: U301.J7 (CK)
GND: C301.2, C302.2, C303.2, C304.2, C305.2, C306.2, C307.2, C308.2, C309.2, C310.2, C311.2, C312.2, C313.2, C314.2, C315.2, C317.2, C318.2, C319.2, R301.1, R303.2, U301.A9 (VSS), U301.B1 (VSSQ), U301.B3 (VSS), U301.B9 (VSSQ), U301.D1 (VSSQ), U301.D8 (VSSQ), U301.E1 (VSS), U301.E2 (VSSQ), U301.E8 (VSSQ), U301.F9 (VSSQ), U301.G1 (VSSQ), U301.G8 (VSS), U301.G9 (VSSQ), U301.J2 (VSS), U301.J8 (VSS), U301.M1 (VSS), U301.M9 (VSS), U301.P1 (VSS), U301.P9 (VSS), U301.T1 (VSS), U301.T9 (VSS)
LDM: U301.E7 (LDM)
LDQS: U301.F3 (LDQS)
ODT: U301.K1 (ODT)
UDM: U301.D3 (UDM)
UDQS: U301.C7 (UDQS)
VREF: C316.2, C317.1, C318.1, C319.1, R302.2, R303.1, U301.H1 (VREFDQ), U301.M8 (VREFCA)
ZQ: R301.2, U301.L8 (ZQ)
adr0: U301.N3 (A0)
adr1: U301.P7 (A1)
adr2: U301.P3 (A2)
adr3: U301.N2 (A3)
adr4: U301.P8 (A4)
adr5: U301.P2 (A5)
adr6: U301.R8 (A6)
adr7: U301.R2 (A7)
adr8: U301.T8 (A8)
adr9: U301.R3 (A9)
adr10: U301.L7 (A10/AP)
adr11: U301.R7 (A11)
adr12: U301.N7 (A12/~BC)
adr13: U301.T3 (A13)
adr14: U301.T7 (A14)
adr15: U301.M7 (A15)
d0: U301.E3 (DQ0)
d1: U301.F7 (DQ1)
d2: U301.F2 (DQ2)
d3: U301.F8 (DQ3)
d4: U301.H3 (DQ4)
d5: U301.H8 (DQ5)
d6: U301.G2 (DQ6)
d7: U301.H7 (DQ7)
d8: U301.B8 (DQ14)
d9: U301.A7 (DQ12)
d10: U301.C8 (DQ10)
d11: U301.C2 (DQ11)
d12: U301.D7 (DQ8)
d13: U301.A2 (DQ13)
d14: U301.C3 (DQ9)
d15: U301.A3 (DQ15)
dba0: U301.M2 (BA0)
dba1: U301.N8 (BA1)
dba2: U301.M3 (BA2)

Notes on the sheet:
OG Part AS4C512M16D3L-12BIN
DDR3L 96Pin BGA
