stanley-fork/Blackpants/ee/integrated/wifi.kicad_sch

## KiCad design ee/integrated/wifi.kicad_sch (2026-06-06)

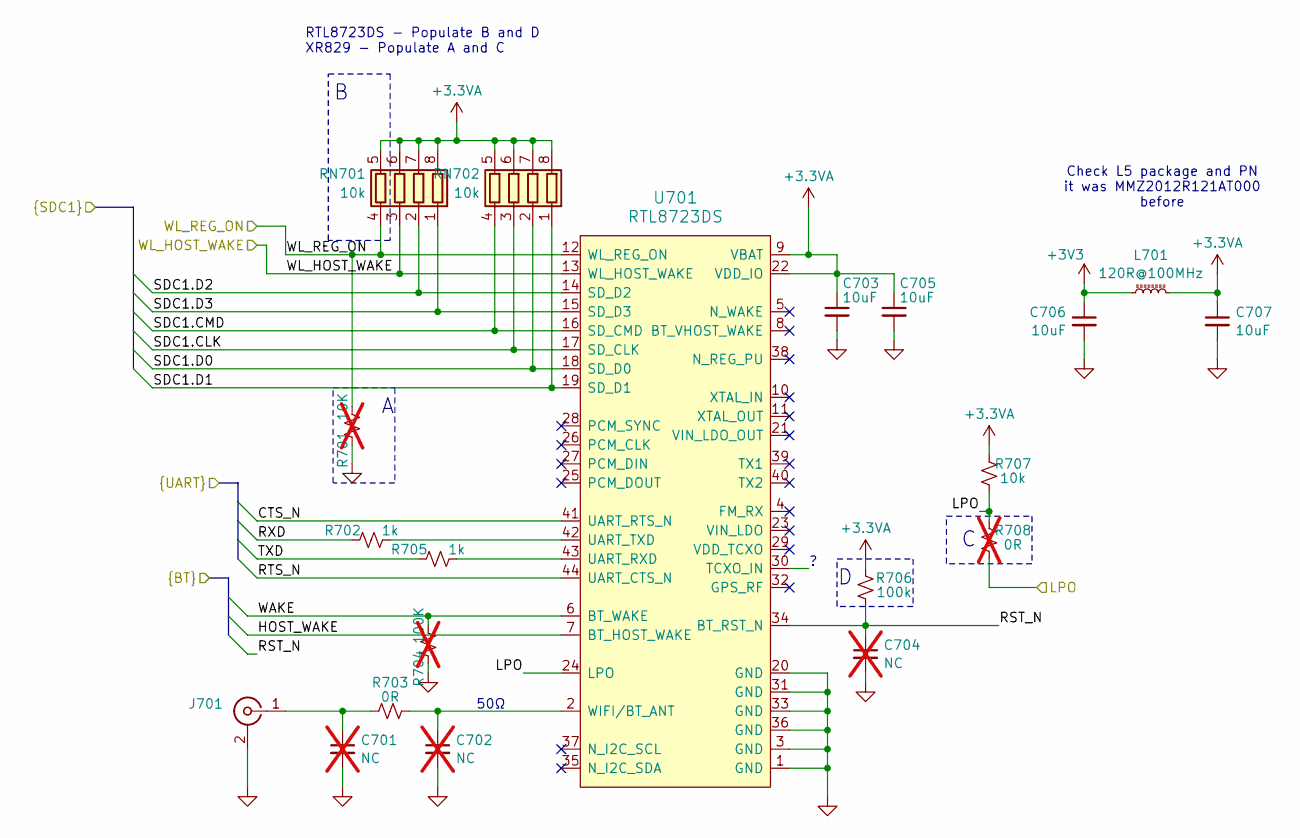
[picture p35: schematic wifi.kicad_sch]

Parts:
C701, C702, C704: NC; C_0402_1005Metric; not fitted
C703, C705, C706, C707: 10uF; C_0603_1608Metric; MPN LMK107BBJ106MALT
J701: Conn_Coaxial; SMA_Amphenol_901-143_Horizontal; MPN SMA-KWE901
L701: 120R@100MHz; L_0603_1608Metric; MPN BLM18KG121TN1D
R701: 10K; R_0402_1005Metric; not fitted
R702, R705: 1k; R_0402_1005Metric; MPN RC0402JR-071KL
R703: 0R; R_0402_1005Metric; MPN RC0402FR-070RL
R704: 100K; R_0402_1005Metric; not fitted
R706: 100k; R_0402_1005Metric; MPN RC0402FR-13100KL
R707: 10k; R_0402_1005Metric; MPN RC0402JR-0710KL
R708: 0R; R_0402_1005Metric; not fitted
RN701, RN702: 10k; R_Array_Convex_4x0402; MPN 4D02WGJ0103TCE
U701: RTL8723DS; RTL8723; MPN RTL8723DS

Connections:
+3.3VA: C703.1, C705.1, C707.1, L701.2, R706.2, R707.2, RN701.5 (R4.2), RN701.6 (R3.2), RN701.7 (R2.2), RN701.8 (R1.2), RN702.5 (R4.2), RN702.6 (R3.2), RN702.7 (R2.2), RN702.8 (R1.2), U701.9 (VBAT), U701.22 (VDD_IO)
+3V3: C706.1, L701.1
CTS_N: U701.41 (UART_RTS_N)
GND: C701.2, C702.2, C703.2, C704.2, C705.2, C706.2, C707.2, J701.2 (Ext), R701.1, R704.1, U701.1 (GND), U701.3 (GND), U701.20 (GND), U701.31 (GND), U701.33 (GND), U701.36 (GND)
HOST_WAKE: U701.7 (BT_HOST_WAKE)
LPO: R707.1, R708.1, R708.2, U701.24 (LPO)
unnamed: C701.1, J701.1 (In), R703.1
unnamed: C702.1, R703.2, U701.2 (WIFI/BT_ANT)
unnamed: R702.2, U701.42 (UART_TXD)
unnamed: R705.2, U701.43 (UART_RXD)
RST_N: C704.1, R706.1, U701.34 (BT_RST_N)
RTS_N: U701.44 (UART_CTS_N)
RXD: R702.1
SDC1.CLK: RN702.3 (R3.1), U701.17 (SD_CLK)
SDC1.CMD: RN702.4 (R4.1), U701.16 (SD_CMD)
SDC1.D0: RN702.2 (R2.1), U701.18 (SD_D0)
SDC1.D1: RN702.1 (R1.1), U701.19 (SD_D1)
SDC1.D2: RN701.2 (R2.1), U701.14 (SD_D2)
SDC1.D3: RN701.1 (R1.1), U701.15 (SD_D3)
TXD: R705.1
WAKE: R704.2, U701.6 (BT_WAKE)
WL_HOST_WAKE: RN701.3 (R3.1), U701.13 (WL_HOST_WAKE)
WL_REG_ON: R701.2, RN701.4 (R4.1), U701.12 (WL_REG_ON)

Notes on the sheet:
Check L5 package and PN it was MMZ2012R121AT000 before
RTL8723DS - Populate B and D XR829 - Populate A and C
50Ω
