stanley-fork/Blackpants/(commit log)

2026-06-06 Moved some files around
    [M20-7910842R.STEP, M20-7911042R.STEP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]
2026-06-06 Split the project and moved some things around.
    [1050570001.stp, AW-A33.step, Abracon_-_ABS05-32.768KHZ-9-T.step, Alliance_Memory_-_AS4C512M16D3L-12BIN.step, CONREVSMA002-G.step, Coilcraft-XAL4020.step, DM3AT-SF-PEJM5.stp, M20-7910842R.STEP]
